cloudrift-ai/aipc/docs/system-check.md

# System check

Generated by `make check` from the part specs in [parts/](../parts/README.md), the assembly coverage in [models/assembly-bom.json](../models/assembly-bom.json) and the renders. Do not edit by hand.

Statuses: **FAIL** means declared data conflicts; **BLOCKED** means the data needed to decide is missing; **provisional** means it passes, but on weak evidence (listing, photo estimate, allowance, assumption) or a configured limit; **pass** means it passes on datasheet, standard or measured values only. A check run against the same assumed numbers does not validate them.

**Summary:** 23 BLOCKED, 56 provisional, 11 pass

## Unspecified parts

These parts have not been chosen, so nothing that depends on them can be checked:

- [mains-power](../parts/purchased/mains-power/README.md): AC supply for both PSUs
- [rack-cabinet](../parts/purchased/rack-cabinet/README.md): cabinet that receives the shelf and the roof exhaust

## Compatibility

| Status | Rule | Interface | Detail |
| --- | --- | --- | --- |
| BLOCKED | budget | `ac-power` | load 2531.0 W; capacity unknown |
| BLOCKED | value | `cabinet-front-clearance` | system needs 20.0; provider value unknown (H115i fan screws reach Y-20, in front of the front rail plane at the deck front (Y0); door must clear) |
| BLOCKED | value | `cabinet-height-above-shelf` | system needs 400.0; provider value unknown (where the roof flange was placed, not a derived need: the pressure fan top is Z233.4 and the 6 in duct bend adds to that. Replace with the real cabinet ceiling once known) |
| BLOCKED | value | `cabinet-rear-clearance` | system needs 176.3; provider value unknown (rear AIO screw heads at Y852.5 behind the rear rail plane at Y711.2 (28 in rail distance) plus 35 mm driver reserve; more at shorter rail distances) |
| BLOCKED | count | `gpu-power` | need 1 x gpu-power=12v-2x6, have None |
| BLOCKED | presence | `pcie-card-airflow` | nothing in systems ['berserk', 'kenshin'] provides 'pcie-card-airflow' |
| BLOCKED | presence | `qsfp28-dac` | nothing in systems ['berserk', 'kenshin'] provides 'qsfp28-dac' |
| BLOCKED | value | `rack-post-depth` | hammond-rsus1931bk1 needs 457.2..711.2; provider value unknown (front-to-rear rack-post spacing range accepted by the slides) |
| BLOCKED | value | `rack-standard` | hammond-rsus1931bk1 needs EIA-310 19 in; provider value unknown |
| BLOCKED | count | `rack-units` | need 11 x rack-units, have None |
| BLOCKED | count | `sata-power` | need 1 x sata-power, have None |
| BLOCKED | count | `usb2-header` | need 1 x usb2-header, have None |
| provisional | value | `aio-pump-mount` | asetek-tr4-bracket needs Asetek round pump; provided by corsair-h115i |
| provisional | count | `aio-pump-mount` | need 1 x aio-pump-mount=asetek round pump, have 1 |
| provisional | count | `atx-24pin` | need 1 x atx-24pin, have 1 |
| provisional | count | `atx-24pin` | need 1 x atx-24pin, have 1 |
| provisional | value | `board-standoff` | gigabyte-x870e-aorus-pro needs #6-32 F/F; provided by keystone-1451b (ATX pattern; B optional if the PCB has it) |
| provisional | value | `board-standoff` | huananzhi-h12d-8d needs #6-32 F/F; provided by keystone-1451b (populated sites A/C/F/G/H/K/L/M) |
| provisional | count | `board-standoff` | need 17 x board-standoff=#6-32 f/f, have 17 |
| provisional | value | `cooler-mount` | amd-epyc-7702p needs SP3; provided by asetek-tr4-bracket (the SP3 IHS is far larger than a round desktop cold plate) |
| provisional | budget | `dc-power` | load 1096.0 W of 1600.0 W x derate 0.8 = 1280.0 W (68% of rating); relies on configured limits of ['nvidia-v100-pcie-16gb']; unlimited peak 1376.0 W |
| provisional | budget | `dc-power` | load 908.0 W of 1200.0 W x derate 0.8 = 960.0 W (76% of rating) |
| provisional | budget | `dc-power` | load 23.2 W of 2800.0 W x derate 0.8 = 2240.0 W (1% of rating) |
| provisional | value | `duct-connection` | flex-duct-6in needs 6 in; provided by gpu_exhaust_fan_flange, gpu_exhaust_roof_flange |
| provisional | count | `duct-connection` | need 2 x duct-connection=6 in, have 2 |
| provisional | count | `eps-8pin-cpu` | need 2 x eps-8pin-cpu, have 2 |
| provisional | count | `eps-8pin-cpu` | need 2 x eps-8pin-cpu, have 2 |
| provisional | value | `fan-mount` | sanyo-denki-9gv1412p1s001 needs 140 mm, 124.5 mm pitch; provided by gpu_exhaust_fan_flange, v100_gpu_shroud (inlet on the hood panel, outlet on the exhaust flange) |
| provisional | count | `fan-mount` | need 2 x fan-mount=140 mm, 124.5 mm pitch, have 2 |
| provisional | value | `fan-power` | sanyo-denki-9gv1412p1s001 needs 12 V PWM 4-wire, 3.1 A; provided by fan-power-harness |
| provisional | count | `fan-power` | need 1 x fan-power=12 v pwm 4-wire, 3.1 a, have 1 |
| provisional | value | `fan-pwm-control` | fan-power-harness needs 25 kHz PWM + tach, Linux hwmon; provided by aquacomputer-quadro |
| provisional | count | `fan-pwm-control` | need 1 x fan-pwm-control=25 khz pwm + tach, linux hwmon, have 4 |
| provisional | count | `gpu-forced-airflow` | need 4 x gpu-forced-airflow, have 4 |
| provisional | value | `gpu-power` | zotac-rtx-5090-solid needs 12V-2x6; provided by corsair-hx1200i |
| provisional | value | `m2-slot` | micron-3400-2tb needs M.2 2280 NVMe; provided by huananzhi-h12d-8d |
| provisional | value | `m2-slot` | micron-3500-2tb needs M.2 2280 NVMe; provided by huananzhi-h12d-8d |
| provisional | count | `m2-slot` | need 3 x m2-slot=m.2 2280 nvme, have 3 |
| provisional | value | `m2-slot` | samsung-990-pro-4tb needs M.2 2280 NVMe; provided by gigabyte-x870e-aorus-pro |
| provisional | count | `m2-slot` | need 2 x m2-slot=m.2 2280 nvme, have 4 |
| provisional | value | `memory-slot` | corsair-cmp64gx5m4b6400c32 needs DDR5 UDIMM; provided by gigabyte-x870e-aorus-pro |
| provisional | count | `memory-slot` | need 4 x memory-slot=ddr5 udimm, have 4 |
| provisional | value | `memory-slot` | micron-mta36asf4g72pz-2g9 needs DDR4 RDIMM; provided by huananzhi-h12d-8d |
| provisional | count | `memory-slot` | need 8 x memory-slot=ddr4 rdimm, have 8 |
| provisional | value | `mobo-front-section` | gigabyte-x870e-aorus-pro needs ATX; provided by atx_mobo_adapter_front |
| provisional | value | `mobo-front-section` | huananzhi-h12d-8d needs ATX; provided by atx_mobo_adapter_front |
| provisional | count | `mobo-front-section` | need 2 x mobo-front-section=atx, have 2 |
| provisional | value | `mobo-rear-rail` | gigabyte-x870e-aorus-pro needs ATX standard slot positions; provided by atx_mobo_adapter_rail |
| provisional | count | `mobo-rear-rail` | need 1 x mobo-rear-rail=atx standard slot positions, have 1 |
| provisional | value | `mobo-rear-rail` | huananzhi-h12d-8d needs H12D-8D slot positions; provided by h12d_mobo_adapter_rail |
| provisional | count | `mobo-rear-rail` | need 1 x mobo-rear-rail=h12d-8d slot positions, have 1 |
| provisional | count | `pcie-8pin` | need 8 x pcie-8pin, have 8 |
| provisional | value | `pcie-card-envelope` | nvidia-v100-pcie-16gb needs 40.0; provided by huananzhi-h12d-8d |
| provisional | value | `pcie-x4-slot` | nvidia-mcx4131a-gcat needs PCIe x8 card, x4 link; provided by gigabyte-x870e-aorus-pro, linkreal-lrfc6911n (x8 edge connector, PCIe 3.0 8 GT/s; needs an open-ended or x16 physical slot; x4 electrical trains at x4) |
| provisional | count | `pcie-x4-slot` | need 2 x pcie-x4-slot=pcie x8 card, x4 link, have 3 |
| provisional | count | `peripheral-12v` | need 1 x peripheral-12v, have 2 |
| provisional | value | `psu-restraint` | corsair-hx1200i needs ATX 150 x 86 face; provided by psu_bracket |
| provisional | value | `psu-restraint` | rosewill-hercules-1600 needs ATX 150 x 86 face; provided by psu_bracket |
| provisional | count | `psu-restraint` | need 2 x psu-restraint=atx 150 x 86 face, have 2 |
| provisional | value | `radiator-mount` | corsair-h115i needs 280 mm, 124.5 mm pitch; provided by fan140_aio_frame |
| provisional | count | `radiator-mount` | need 2 x radiator-mount=280 mm, 124.5 mm pitch, have 2 |
| provisional | value | `radiator-mount` | lian-li-ga2-lite-360 needs 360 mm, 105 mm pitch; provided by fan120_aio_frame |
| provisional | count | `radiator-mount` | need 2 x radiator-mount=360 mm, 105 mm pitch, have 2 |
| provisional | value | `sff-8643-port` | sff-8643-pcie-cable needs PCIe x4 device; provided by linkreal-lrfc6911n (device end on the riser) |
| provisional | count | `sff-8643-port` | need 1 x sff-8643-port=pcie x4 device, have 1 |
| provisional | budget | `shelf-load` | load 23.7 kg of 39.0 kg x derate 1.0 = 39.0 kg (61% of rating) |
| provisional | value | `v100-aux-power` | nvidia-v100-pcie-16gb needs CPU/EPS 8-pin; provided by v100-eps-power-adapter |
| provisional | count | `v100-aux-power` | need 4 x v100-aux-power=cpu/eps 8-pin, have 4 |
| pass | value | `cooler-mount` | amd-ryzen-9-9950x3d needs AM5; provided by lian-li-ga2-lite-360 |
| pass | value | `cpu-socket` | amd-epyc-7702p needs SP3; provided by huananzhi-h12d-8d |
| pass | value | `cpu-socket` | amd-ryzen-9-9950x3d needs AM5; provided by gigabyte-x870e-aorus-pro |
| pass | value | `pcie-x16-slot` | nvidia-v100-pcie-16gb needs PCIe x16; provided by huananzhi-h12d-8d (PCIe 3.0 card in a PCIe 4.0 slot) |
| pass | count | `pcie-x16-slot` | need 4 x pcie-x16-slot=pcie x16, have 4 |
| pass | value | `pcie-x16-slot` | zotac-rtx-5090-solid needs PCIe x16; provided by gigabyte-x870e-aorus-pro |
| pass | count | `pcie-x16-slot` | need 1 x pcie-x16-slot=pcie x16, have 1 |
| pass | value | `post-base-thread` | obt-pcie-support needs M3 female; provided by wurth-970140324 |
| pass | count | `post-base-thread` | need 10 x post-base-thread=m3 female, have 10 |
| pass | value | `sff-8643-port` | sff-8643-pcie-cable needs PCIe 4.0 x4 U.2; provided by huananzhi-h12d-8d (host end on an H12D-8D SFF-8643 port set to PCIe mode) |
| pass | count | `sff-8643-port` | need 1 x sff-8643-port=pcie 4.0 x4 u.2, have 3 |

## Assembly coverage

Every assembly instance belongs to a part folder or a declared keepout. Parts not in the assembly, and unresolved geometry conflicts the layout reports:

- **aquacomputer-quadro**: not in the assembly: outline not published and mounting place not chosen; small enough for the hood side or the H12D front edge
- **corsair-cmp64gx5m4b6400c32**: not in the assembly: X870E DIMM socket positions not surveyed; model them before trusting pump and hose clearance
- **linkreal-lrfc6911n**: not in the assembly: shelf location and holder not designed yet; must clear the V100s and the BMC and leave airflow over the NIC
- **mains-power**: not in the assembly: outside the shelf; supply not specified
- **nvidia-mcx4131a-gcat**: not in the assembly: card positions not chosen: Berserk's sits on a riser whose shelf location is open, and Kenshin's PCIEX4 slot clearance under the RTX 5090 is unchecked
- **samsung-990-pro-4tb**: not in the assembly: X870E M.2 slot positions not surveyed; drives sit under the board heatsinks
- **sff-8643-pcie-cable**: not in the assembly: cable route follows the riser location, which is not chosen yet
- **tnut_fit_coupon**: not in the assembly: fit coupon, not installed
- **fan-power-harness**: not in the assembly: flexible wiring; route along the hood clear of the fan rotor
- **Berserk V100 16GB PCIE2 / Berserk BMC module survey**: geometry conflict in the layout: unresolved conservative envelopes: BMC height and GPU underside are unmeasured; inspect actual clearance before assembly
- **Berserk V100 16GB PCIE3 / Berserk BMC module survey**: geometry conflict in the layout: unresolved conservative envelopes: BMC height and GPU underside are unmeasured; inspect actual clearance before assembly

## Datasheets

- **ac-power-cords**: no datasheet recorded. Not selected. HX1200i wants a low-profile or down-exit C13; match the Hercules inlet and the UPS outlet (possibly C19).
- **asetek-tr4-bracket**: no datasheet recorded. Not yet sourced. Record the product and confirm it lists the original H115i pump before buying.
- **corsair-cmp64gx5m4b6400c32**: no datasheet recorded. Add Corsair's product page for this kit.
- **corsair-h115i**: no datasheet recorded. Reused unit; exact revision not recorded. Add the Corsair spec sheet for that revision.
- **corsair-hx1200i**: no datasheet recorded. Revision not recorded: the 2017 HX1200i (CP-9020070, 200 mm) has no 12V-2x6 cable; the 2023 ATX 3.x unit (CP-9020281) has one. Record the label and add its spec sheet.
- **fasteners**: no datasheet recorded. Generic ISO metric hardware; choose lengths from measured stacks (see docs/assembly.md).
- **flex-duct-6in**: no datasheet recorded. Not selected; any 152 mm ID wire-supported duct.
- **keystone-1451b**: no datasheet recorded. Only the DigiKey listing is recorded; add Keystone's drawing.
- **moddiy-eps-90-extension**: no datasheet recorded. MODDIY product page not recorded; the 18 mm projection is a design target, not a product dimension.
- **obt-pcie-support**: no datasheet recorded. Open Benchtable publishes no drawing; the stud length is an owner measurement.
- **rosewill-hercules-1600**: no datasheet recorded. Owned unit; record its model number and add Rosewill's spec sheet. Connector counts below are assumptions.
- **sff-8643-pcie-cable**: no datasheet recorded. Marketplace cable; 10Gtek publishes no drawing or PCIe rating for it. Listings give 12G SAS, 100 ohm, 30 AWG, sideband.
- **silicone-gasket-2mm**: no datasheet recorded. Generic sheet.
- **v100-eps-power-adapter**: no datasheet recorded. Generic marketplace adapter; check its pinout against the NVIDIA brief before use.
- **v100-tail-support**: no datasheet recorded. Generic hardware; choose after measuring the card frame height.

Not fetched locally (run `make datasheets`): amd-epyc-7702p, amd-ryzen-9-9950x3d, gigabyte-x870e-aorus-pro, micron-3500-2tb, wurth-970140324, zotac-rtx-5090-solid.

## Weak-evidence dimensions

Dimensions not backed by a datasheet, standard or measurement, by part:

- amd-epyc-7702p: 1 assumed, 1 datasheet
- amd-ryzen-9-9950x3d: 1 assumed, 1 datasheet, 1 standard
- aquacomputer-quadro: 1 assumed, 1 datasheet
- asetek-tr4-bracket: 1 assumed
- atx_mobo_adapter_front: 1 allowance
- atx_mobo_adapter_rail: 1 allowance
- corsair-cmp64gx5m4b6400c32: 1 assumed
- corsair-h115i: 4 assumed, 3 standard
- corsair-hx1200i: 2 assumed, 2 standard
- fan-power-harness: 1 allowance, 1 assumed
- fan120_aio_center_spacer: 1 allowance
- fan120_aio_frame: 1 allowance
- fan120_aio_hose_brace: 1 allowance
- fan140_aio_frame: 1 allowance
- fan140_aio_hose_brace: 1 allowance
- fasteners: 1 assumed
- gigabyte-x870e-aorus-pro: 1 assumed, 2 datasheet
- gpu_exhaust_fan_flange: 1 allowance
- gpu_exhaust_roof_flange: 1 allowance
- gpu_rest: 1 allowance
- h12d_mobo_adapter_rail: 1 allowance
- hammond-rsus1931bk1: 1 allowance, 10 datasheet, 3 photo-estimate, 1 unknown
- huananzhi-h12d-8d: 2 assumed, 2 datasheet
- keystone-1451b: 1 assumed, 1 listing
- lian-li-ga2-lite-360: 1 allowance, 1 assumed, 6 datasheet, 1 standard
- micron-3400-2tb: 2 assumed, 5 datasheet
- micron-3500-2tb: 2 assumed, 2 standard
- micron-mta36asf4g72pz-2g9: 2 assumed
- moddiy-eps-90-extension: 1 allowance, 1 assumed
- nvidia-mcx4131a-gcat: 1 assumed, 5 datasheet
- nvidia-v100-pcie-16gb: 1 allowance, 4 datasheet
- obt-pcie-support: 1 allowance, 1 assumed, 1 measured
- psu_bracket: 1 allowance
- rack-cabinet: 3 unknown
- rear-aio-steel-extension: 4 allowance
- rosewill-hercules-1600: 1 allowance, 1 assumed, 2 standard
- samsung-990-pro-4tb: 1 assumed
- sff-8643-pcie-cable: 1 assumed, 1 listing
- tnut_fit_coupon: 1 allowance
- v100-eps-power-adapter: 1 assumed
- v100-tail-support: 2 allowance, 1 assumed
- v100_gpu_shroud: 1 allowance
- wurth-970140324: 1 assumed, 3 datasheet
- zotac-rtx-5090-solid: 1 assumed, 4 datasheet
