cloudrift-ai/aipc/models/aio-fan-aligned-mounts.png

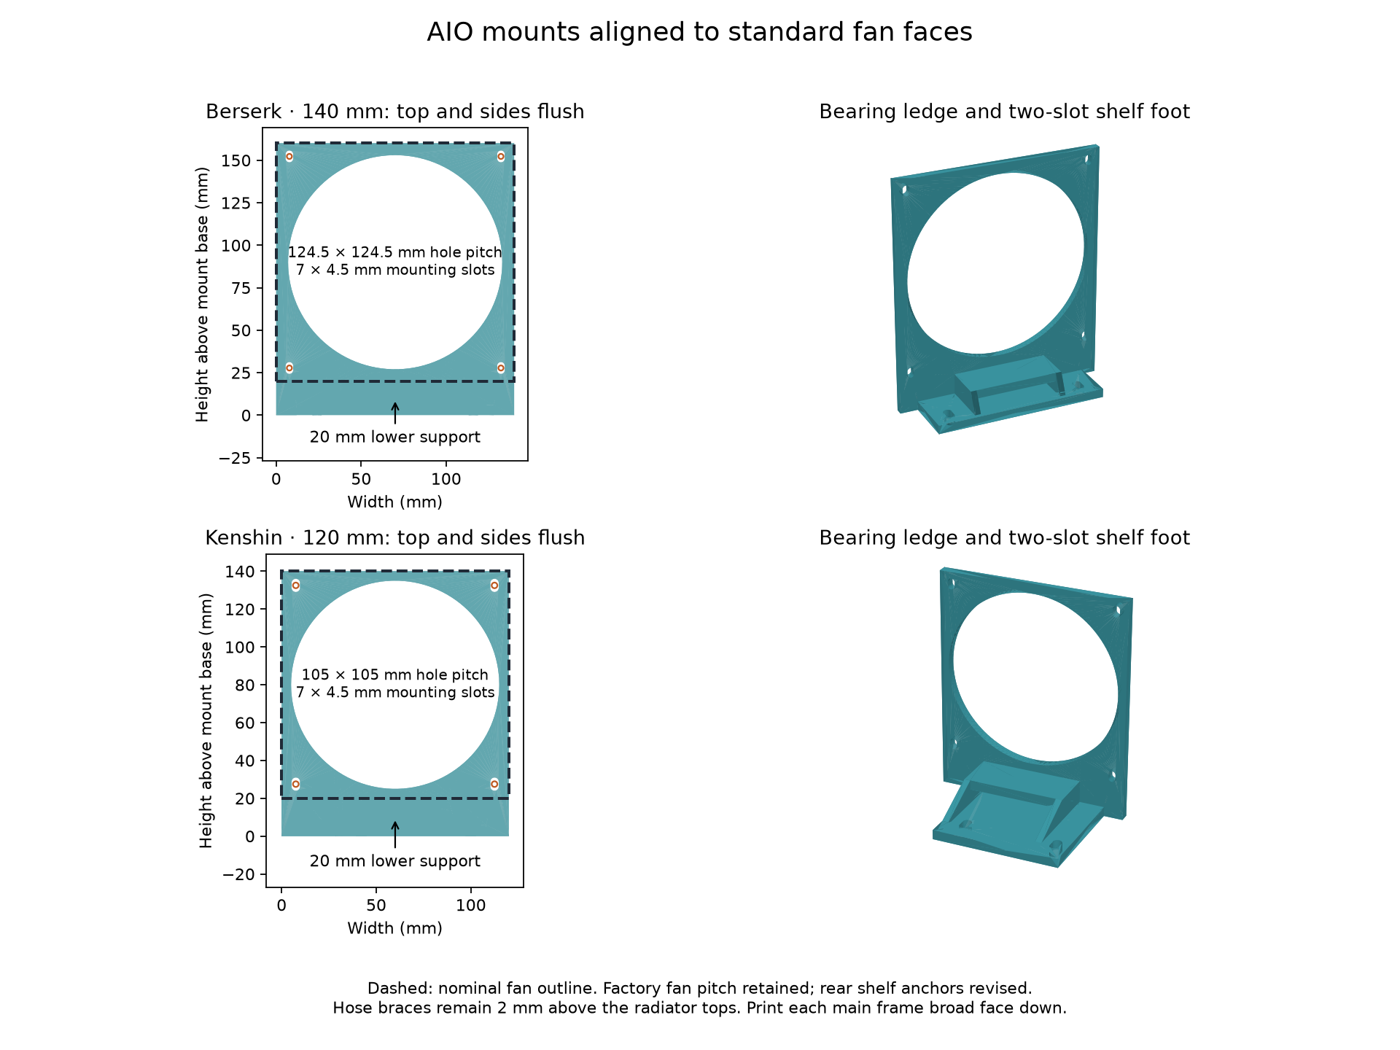
models/aio-fan-aligned-mounts.png
