cloudrift-ai/aipc/models/gpu-exhaust-preview.png

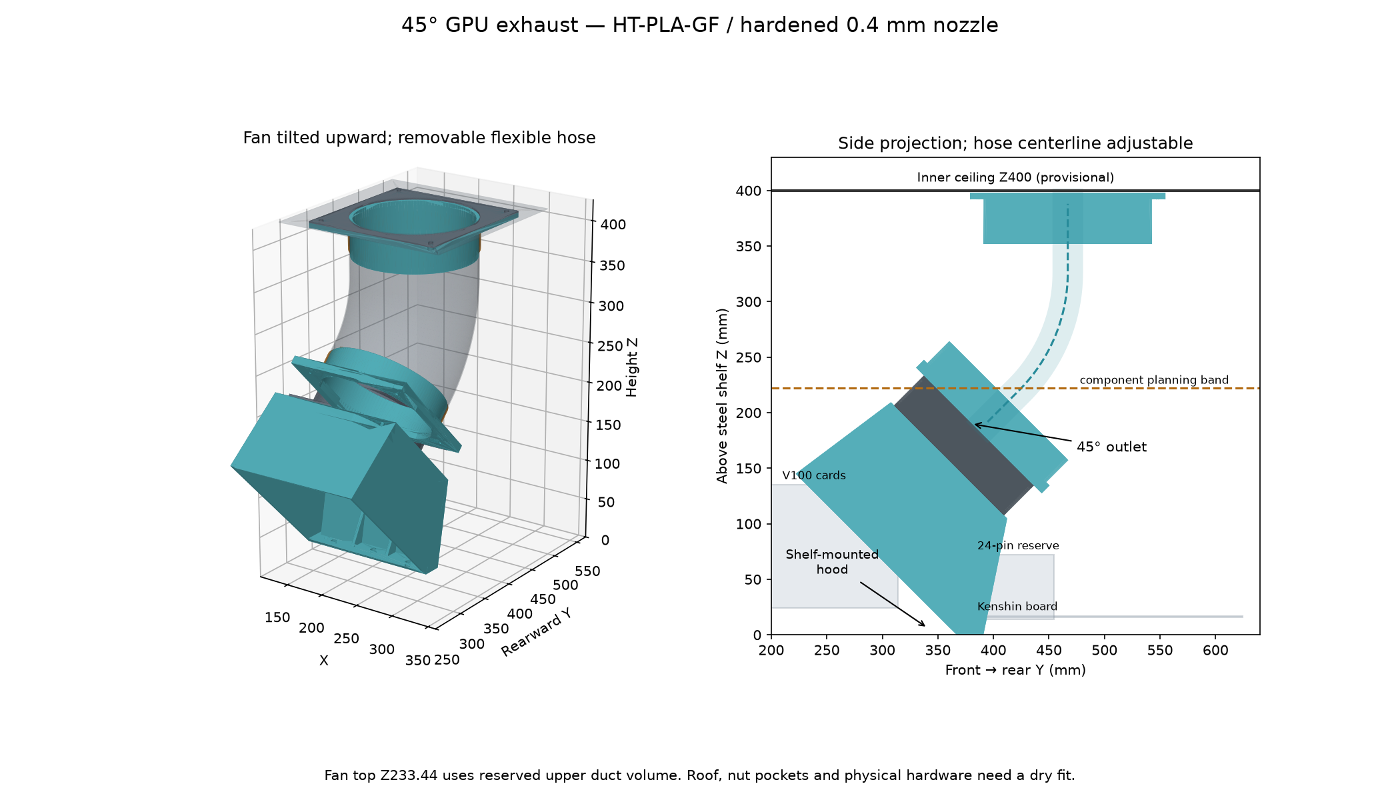
models/gpu-exhaust-preview.png
