cloudrift-ai/aipc/models/kenshin-aio-brace-and-frames.png

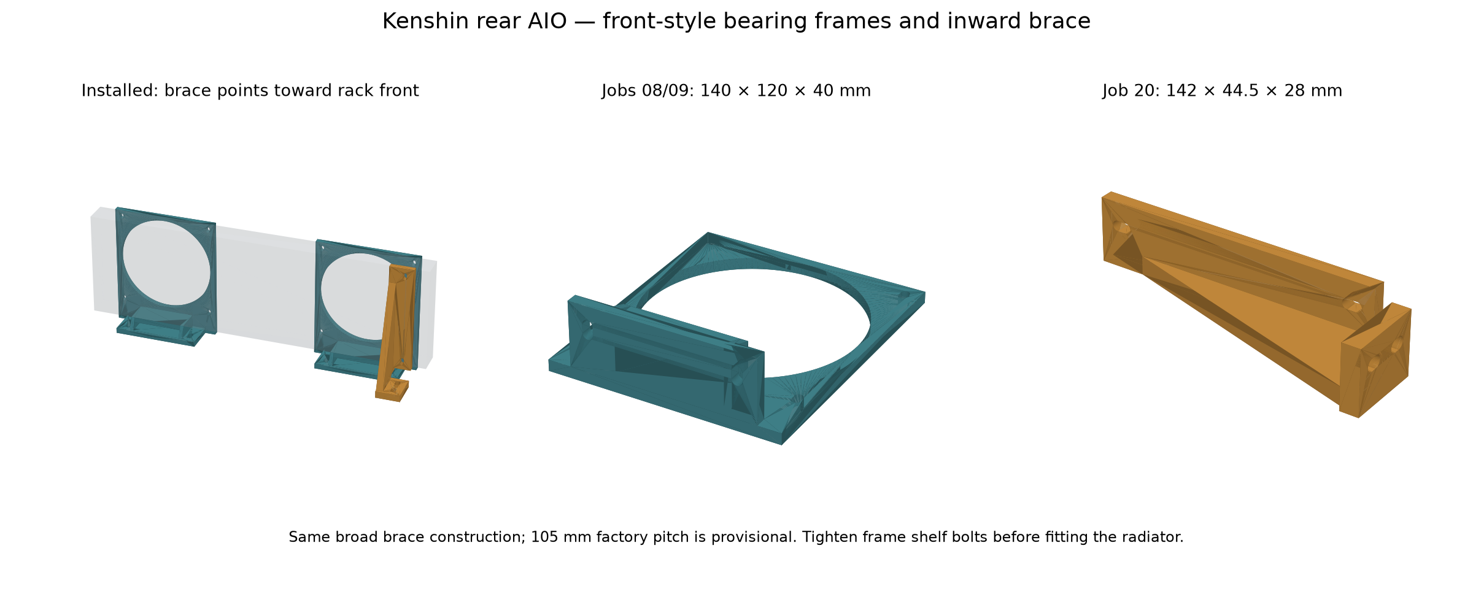
models/kenshin-aio-brace-and-frames.png
