cloudrift-ai/aipc/models/v100-cooling.png

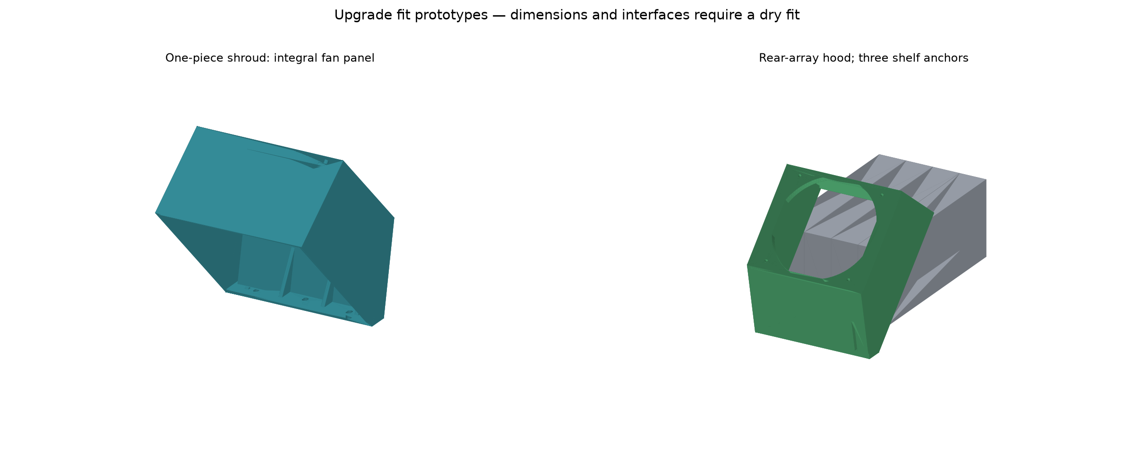
models/v100-cooling.png
