cloudrift-ai/aipc/parts/README.md

# Parts

<!-- Generated by make check. Edit each part.toml, not this file. -->

One folder per part: `part.toml` (spec, evidence, interfaces), a generated `README.md`, the model used in the assembly (`<id>.step`), `render.png` and `in-assembly.png`, and fetched `datasheets/`. See [docs/process.md](../docs/process.md) for the workflow and [docs/system-check.md](../docs/system-check.md) for the latest compatibility results.

## Purchased

| Part | Qty | Status | Systems | Worst check | Role |
| --- | ---: | --- | --- | --- | --- |
| [ac-power-cords](purchased/ac-power-cords/README.md) | 2 | candidate | berserk, kenshin | - | PSU mains cords |
| [amd-epyc-7702p](purchased/amd-epyc-7702p/README.md) | 1 | owned | berserk | provisional | Berserk CPU |
| [amd-ryzen-9-9950x3d](purchased/amd-ryzen-9-9950x3d/README.md) | 1 | owned | kenshin | pass | Kenshin CPU |
| [aquacomputer-quadro](purchased/aquacomputer-quadro/README.md) | 1 | selected | berserk | BLOCKED | PWM and tach for the V100 pressure fan, driven from GPU temperature by the host |
| [asetek-tr4-bracket](purchased/asetek-tr4-bracket/README.md) | 1 | selected | berserk | provisional | mounts the H115i pump on the EPYC SP3 socket |
| [corsair-cmp64gx5m4b6400c32](purchased/corsair-cmp64gx5m4b6400c32/README.md) | 1 | owned | kenshin | provisional | Kenshin memory |
| [corsair-h115i](purchased/corsair-h115i/README.md) | 1 | owned | berserk | provisional | Berserk CPU cooler, front of shelf |
| [corsair-hx1200i](purchased/corsair-hx1200i/README.md) | 1 | owned | kenshin | BLOCKED | Kenshin PSU |
| [fasteners](purchased/fasteners/README.md) | 1 | candidate | berserk, kenshin, shelf | - | 45 shelf joints plus radiator, fan, flange and roof screws |
| [flex-duct-6in](purchased/flex-duct-6in/README.md) | 1 | candidate | berserk | provisional | GPU exhaust to cabinet ceiling |
| [gigabyte-x870e-aorus-pro](purchased/gigabyte-x870e-aorus-pro/README.md) | 1 | owned | kenshin | provisional | Kenshin motherboard |
| [hammond-rsus1931bk1](purchased/hammond-rsus1931bk1/README.md) | 1 | selected | shelf, rack | BLOCKED | sliding shelf carrying both PCs |
| [huananzhi-h12d-8d](purchased/huananzhi-h12d-8d/README.md) | 1 | owned | berserk | BLOCKED | Berserk motherboard |
| [keystone-1451b](purchased/keystone-1451b/README.md) | 17 | selected | berserk, kenshin | provisional | motherboard standoffs |
| [lian-li-ga2-lite-360](purchased/lian-li-ga2-lite-360/README.md) | 1 | owned | kenshin | provisional | Kenshin CPU cooler, rear of shelf |
| [linkreal-lrfc6911n](purchased/linkreal-lrfc6911n/README.md) | 1 | selected | berserk | BLOCKED | Berserk NIC slot: takes an H12D-8D SFF-8643 PCIe x4 port and provides an x16 slot for the ConnectX |
| [mains-power](purchased/mains-power/README.md) | 1 | unspecified | rack | BLOCKED | AC supply for both PSUs |
| [mcmaster-53185k52](purchased/mcmaster-53185k52/README.md) | 2 | selected | berserk | - | duct clamps |
| [micron-3400-2tb](purchased/micron-3400-2tb/README.md) | 2 | owned | berserk | provisional | Berserk model storage, two of the three RAID 0 members |
| [micron-3500-2tb](purchased/micron-3500-2tb/README.md) | 1 | owned | berserk | provisional | Berserk model storage, one of the three RAID 0 members |
| [micron-mta36asf4g72pz-2g9](purchased/micron-mta36asf4g72pz-2g9/README.md) | 8 | owned | berserk | provisional | Berserk memory, 8 x 32 GB |
| [moddiy-eps-90-extension](purchased/moddiy-eps-90-extension/README.md) | 4 | selected | berserk | - | keeps V100 power plugs low and clear of the front radiator |
| [nvidia-mcx4131a-gcat](purchased/nvidia-mcx4131a-gcat/README.md) | 2 | owned | berserk, kenshin | BLOCKED | Direct Berserk-Kenshin link over a QSFP28 DAC (one card per system) |
| [nvidia-v100-pcie-16gb](purchased/nvidia-v100-pcie-16gb/README.md) | 4 | selected | berserk | provisional | Berserk GPUs (passive, ducted) |
| [obt-pcie-support](purchased/obt-pcie-support/README.md) | 10 | selected | berserk, kenshin | pass | GPU bracket posts (two per card) |
| [rack-cabinet](purchased/rack-cabinet/README.md) | 1 | unspecified | rack | BLOCKED | cabinet that receives the shelf and the roof exhaust |
| [rosewill-hercules-1600](purchased/rosewill-hercules-1600/README.md) | 1 | owned | berserk | BLOCKED | Berserk PSU |
| [samsung-990-pro-4tb](purchased/samsung-990-pro-4tb/README.md) | 2 | owned | kenshin | provisional | Kenshin storage |
| [sanyo-denki-9gv1412p1s001](purchased/sanyo-denki-9gv1412p1s001/README.md) | 1 | selected | berserk | provisional | pressure fan pulling air through the four V100s |
| [sff-8643-pcie-cable](purchased/sff-8643-pcie-cable/README.md) | 1 | selected | berserk | provisional | PCIe x4 link from an H12D-8D SFF-8643 port to the Linkreal LRFC6911N riser |
| [silicone-gasket-2mm](purchased/silicone-gasket-2mm/README.md) | 1 | candidate | berserk | - | roof flange seal |
| [v100-eps-power-adapter](purchased/v100-eps-power-adapter/README.md) | 4 | selected | berserk | provisional | V100 auxiliary power adapter |
| [v100-tail-support](purchased/v100-tail-support/README.md) | 4 | candidate | berserk | - | V100 tail support |
| [wurth-970140324](purchased/wurth-970140324/README.md) | 10 | selected | berserk, kenshin | pass | GPU post bases, bearing directly on the steel shelf |
| [zotac-rtx-5090-solid](purchased/zotac-rtx-5090-solid/README.md) | 1 | owned | kenshin | BLOCKED | Kenshin GPU |

## Printed

| Part | Qty | Status | Systems | Worst check | Role |
| --- | ---: | --- | --- | --- | --- |
| [atx_mobo_adapter_front](printed/atx_mobo_adapter_front/README.md) | 2 | design | berserk, kenshin | provisional | shelf-front motherboard section, common to both boards |
| [atx_mobo_adapter_rail](printed/atx_mobo_adapter_rail/README.md) | 1 | design | kenshin | provisional | Kenshin rear rail with GPU post holes at standard ATX positions |
| [fan120_aio_center_spacer](printed/fan120_aio_center_spacer/README.md) | 1 | design | kenshin | - | keeps the middle 120 mm fan coplanar |
| [fan120_aio_frame](printed/fan120_aio_frame/README.md) | 2 | design | kenshin | provisional | 120 mm fan/radiator frame with 75 mm feet on the steel extension |
| [fan120_aio_hose_brace](printed/fan120_aio_hose_brace/README.md) | 1 | design | kenshin | - | mirrored left hose-end brace for the 120 mm radiator |
| [fan140_aio_frame](printed/fan140_aio_frame/README.md) | 2 | design | berserk | provisional | 140 mm fan/radiator frame with bearing ledge (H115i) |
| [fan140_aio_hose_brace](printed/fan140_aio_hose_brace/README.md) | 1 | design | berserk | - | hose-end brace for the 140 mm radiator |
| [gpu_exhaust_fan_flange](printed/gpu_exhaust_fan_flange/README.md) | 1 | design | berserk | provisional | fan outlet to 6 in duct |
| [gpu_exhaust_roof_flange](printed/gpu_exhaust_roof_flange/README.md) | 1 | design | berserk | provisional | duct to cabinet inner ceiling |
| [gpu_rest](printed/gpu_rest/README.md) | 1 | design | kenshin | - | front-end rest for the RTX 5090 |
| [h12d_mobo_adapter_rail](printed/h12d_mobo_adapter_rail/README.md) | 1 | design | berserk | provisional | Berserk rear rail with GPU post holes for four dual-slot V100s |
| [psu_bracket](printed/psu_bracket/README.md) | 2 | design | berserk, kenshin | provisional | rear restraint for an 86 x 150 mm ATX PSU face |
| [tnut_fit_coupon](printed/tnut_fit_coupon/README.md) | 1 | design | berserk | - | test print for the M4 hammer T-nut pocket |
| [v100_gpu_shroud](printed/v100_gpu_shroud/README.md) | 1 | design | berserk | provisional | hood over the four V100s with integral 45 degree fan panel |

## Fabricated

| Part | Qty | Status | Systems | Worst check | Role |
| --- | ---: | --- | --- | --- | --- |
| [fan-power-harness](fabricated/fan-power-harness/README.md) | 1 | design | berserk | provisional | feeds the San Ace motor from the PSU and passes PWM/tach to the QUADRO |
| [rear-aio-steel-extension](fabricated/rear-aio-steel-extension/README.md) | 1 | design | kenshin, shelf | - | carries the rear radiator feet beyond the deck |
