cloudrift-ai/aipc/parts/purchased/amd-ryzen-9-9950x3d/README.md

# AMD Ryzen 9 9950X3D

<!-- Generated by make check from part.toml. Edit part.toml, not this file. -->

| | |
| --- | --- |
| ID | `amd-ryzen-9-9950x3d` |
| Category | purchased |
| Role | Kenshin CPU |
| Status | owned |
| Quantity | 1 |
| Systems | kenshin |

## Model

- Source: constructed
- Assembly: inside the envelope of `lian-li-ga2-lite-360`

## Datasheets

- [AMD Ryzen 9 9950X3D specifications](https://www.amd.com/en/products/processors/desktops/ryzen/9000-series/amd-ryzen-9-9950x3d.html)
- Local copies: `datasheets/` after `make datasheets` (not committed)

## Dimensions

| Key | Value | Evidence | Source / note |
| --- | --- | --- | --- |
| tdp | 170 W | datasheet | AMD specifications |
| ppt | 230 W | standard | AM5 170 W TDP class package power |
| mass | 0.05 kg | assumed |  |

## Interfaces

- requires `cpu-socket` value AM5 (datasheet)
- requires `cooler-mount` value AM5 (datasheet)
- requires `dc-power` load 230 (standard)

## Compatibility checks

| Status | Rule | Interface | Detail |
| --- | --- | --- | --- |
| provisional | budget | `dc-power` | load 908.0 W of 1200.0 W x derate 0.8 = 960.0 W (76% of rating) |
| provisional | budget | `shelf-load` | load 23.7 kg of 39.0 kg x derate 1.0 = 39.0 kg (61% of rating) |
| pass | value | `cooler-mount` | amd-ryzen-9-9950x3d needs AM5; provided by lian-li-ga2-lite-360 |
| pass | value | `cpu-socket` | amd-ryzen-9-9950x3d needs AM5; provided by gigabyte-x870e-aorus-pro |
