cloudrift-ai/aipc/parts/purchased/aquacomputer-quadro/README.md

# Aquacomputer QUADRO fan controller (53256)

<!-- Generated by make check from part.toml. Edit part.toml, not this file. -->

| | |
| --- | --- |
| ID | `aquacomputer-quadro` |
| Category | purchased |
| Role | PWM and tach for the V100 pressure fan, driven from GPU temperature by the host |
| Status | selected |
| Quantity | 1 |
| Systems | berserk |
| Product | <https://shop.aquacomputer.de/Monitoring-and-Controlling/QUADRO-and-OCTO/QUADRO-fan-controller-for-PWM-fans::3773.html> |
| Linux_driver | <https://docs.kernel.org/hwmon/aquacomputer_d5next.html> |

Chosen 2026-11-06. Each output is rated 25 W, below the San Ace's 37.2 W, so
the QUADRO does not power the fan: the fused harness feeds the motor from the
PSU and only PWM, tach and ground go to a QUADRO channel. On Linux the
aquacomputer_d5next hwmon driver exposes writable pwm1-4 and fan tach; a host
service reads the hottest GPU (nvidia-smi) and writes the duty. If the PWM
line goes open the San Ace runs at 100% (catalog p.185 note), but a running
QUADRO holds its last duty if the host service dies: the service must set
100% on start, on exit and on any error, and stop GPU load if tach is lost.
Initial configuration software (aquasuite) is Windows-only; Linux control
needs no configuration. Whether its outputs float when unpowered is not
documented.

## Model

- Source: constructed
- Assembly: **not in the assembly**: outline not published and mounting place not chosen; small enough for the hood side or the H12D front edge

## Datasheets

- [QUADRO product page](https://shop.aquacomputer.de/Monitoring-and-Controlling/QUADRO-and-OCTO/QUADRO-fan-controller-for-PWM-fans::3773.html)
- [Linux aquacomputer_d5next hwmon driver](https://docs.kernel.org/hwmon/aquacomputer_d5next.html)
- Local copies: `datasheets/` after `make datasheets` (not committed)

## Dimensions

| Key | Value | Evidence | Source / note |
| --- | --- | --- | --- |
| channel_power | 25 W | datasheet | product page: max 25 W per channel |
| mass | 0.1 kg | assumed |  |

## Interfaces

- provides `fan-pwm-control` value 25 kHz PWM + tach, Linux hwmon count 4 (datasheet) — product page: four 4-pin PWM outputs with speed monitoring; kernel driver pwm writable
- requires `usb2-header` count 1 (datasheet) — internal USB 2.0 header; cable about 100 cm included
- requires `dc-power` load 2 (assumed)

## Compatibility checks

| Status | Rule | Interface | Detail |
| --- | --- | --- | --- |
| BLOCKED | count | `usb2-header` | need 1 x usb2-header, have None |
| provisional | budget | `dc-power` | load 1096.0 W of 1600.0 W x derate 0.8 = 1280.0 W (68% of rating); relies on configured limits of ['nvidia-v100-pcie-16gb']; unlimited peak 1376.0 W |
| provisional | value | `fan-pwm-control` | fan-power-harness needs 25 kHz PWM + tach, Linux hwmon; provided by aquacomputer-quadro |
| provisional | count | `fan-pwm-control` | need 1 x fan-pwm-control=25 khz pwm + tach, linux hwmon, have 4 |
| provisional | budget | `shelf-load` | load 23.7 kg of 39.0 kg x derate 1.0 = 39.0 kg (61% of rating) |
