cloudrift-ai/aipc/parts/purchased/asetek-tr4-bracket/README.md

# Asetek TR4/SP3 mounting bracket for round-pump AIOs

<!-- Generated by make check from part.toml. Edit part.toml, not this file. -->

| | |
| --- | --- |
| ID | `asetek-tr4-bracket` |
| Category | purchased |
| Role | mounts the H115i pump on the EPYC SP3 socket |
| Status | selected |
| Quantity | 1 |
| Systems | berserk |

Accepted by the owner on 2026-11-06 with partial cold-plate coverage. SP3 and
TR4 share the same four-post cooler mounting, so a TR4 bracket fits the
H12D-8D. The round H115i cold plate does not cover the whole 58 x 75 mm SP3
heat spreader, and the 7702P's outer dies sit near its edges: expect higher
temperatures and less headroom than a full-coverage TR4/SP3 cooler. Watch
CPU temperatures under all-core load and revisit if it throttles.

## Model

- Source: constructed
- Assembly: inside the envelope of `amd-epyc-7702p`

## Datasheets

- None recorded. Not yet sourced. Record the product and confirm it lists the original H115i pump before buying.

## Dimensions

| Key | Value | Evidence | Source / note |
| --- | --- | --- | --- |
| mass | 0.05 kg | assumed |  |

## Interfaces

- provides `cooler-mount` value SP3 (assumed) — TR4/sTRX4/SP3 share the four-post mounting; cold-plate coverage is partial
- requires `aio-pump-mount` value Asetek round pump count 1 (assumed)

## Compatibility checks

| Status | Rule | Interface | Detail |
| --- | --- | --- | --- |
| provisional | value | `aio-pump-mount` | asetek-tr4-bracket needs Asetek round pump; provided by corsair-h115i |
| provisional | count | `aio-pump-mount` | need 1 x aio-pump-mount=asetek round pump, have 1 |
| provisional | value | `cooler-mount` | amd-epyc-7702p needs SP3; provided by asetek-tr4-bracket |
| provisional | budget | `shelf-load` | load 23.7 kg of 39.0 kg x derate 1.0 = 39.0 kg (61% of rating) |
