cloudrift-ai/aipc/parts/purchased/corsair-cmp64gx5m4b6400c32/README.md

# Corsair CMP64GX5M4B6400C32 DDR5 kit, 4 x 16 GB

<!-- Generated by make check from part.toml. Edit part.toml, not this file. -->

| | |
| --- | --- |
| ID | `corsair-cmp64gx5m4b6400c32` |
| Category | purchased |
| Role | Kenshin memory |
| Status | owned |
| Quantity | 1 |
| Systems | kenshin |

## Model

- Source: constructed
- Assembly: **not in the assembly**: X870E DIMM socket positions not surveyed; model them before trusting pump and hose clearance

## Datasheets

- None recorded. Add Corsair's product page for this kit.

## Dimensions

| Key | Value | Evidence | Source / note |
| --- | --- | --- | --- |
| mass | 0.2 kg | assumed |  |

## Interfaces

- requires `memory-slot` value DDR5 UDIMM count 4 (listing)
- requires `dc-power` load 20 (assumed)

## Compatibility checks

| Status | Rule | Interface | Detail |
| --- | --- | --- | --- |
| provisional | budget | `dc-power` | load 908.0 W of 1200.0 W x derate 0.8 = 960.0 W (76% of rating) |
| provisional | value | `memory-slot` | corsair-cmp64gx5m4b6400c32 needs DDR5 UDIMM; provided by gigabyte-x870e-aorus-pro |
| provisional | count | `memory-slot` | need 4 x memory-slot=ddr5 udimm, have 4 |
| provisional | budget | `shelf-load` | load 23.7 kg of 39.0 kg x derate 1.0 = 39.0 kg (61% of rating) |
