cloudrift-ai/aipc/parts/purchased/corsair-h115i/README.md

# Corsair Hydro H115i 280 mm AIO (reused)

<!-- Generated by make check from part.toml. Edit part.toml, not this file. -->

| | |
| --- | --- |
| ID | `corsair-h115i` |
| Category | purchased |
| Role | Berserk CPU cooler, front of shelf |
| Status | owned |
| Quantity | 1 |
| Systems | berserk |

The retail H115i mounting kit covers Intel and desktop AMD sockets only. On
the EPYC it mounts with a separate TR4/SP3 bracket (asetek-tr4-bracket). The
round cold plate covers only part of the SP3 heat spreader; the owner accepted
that on 2026-11-06.

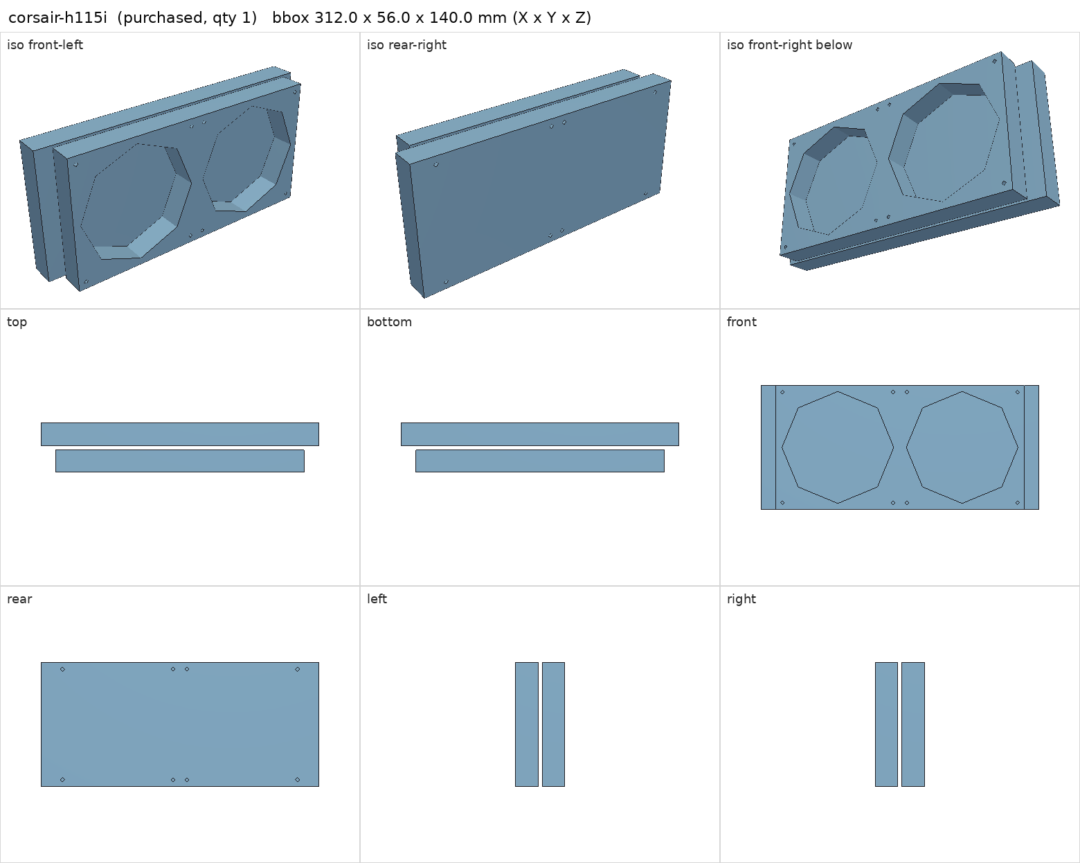
[picture p15: parts/purchased/corsair-h115i/render.png]
Part views


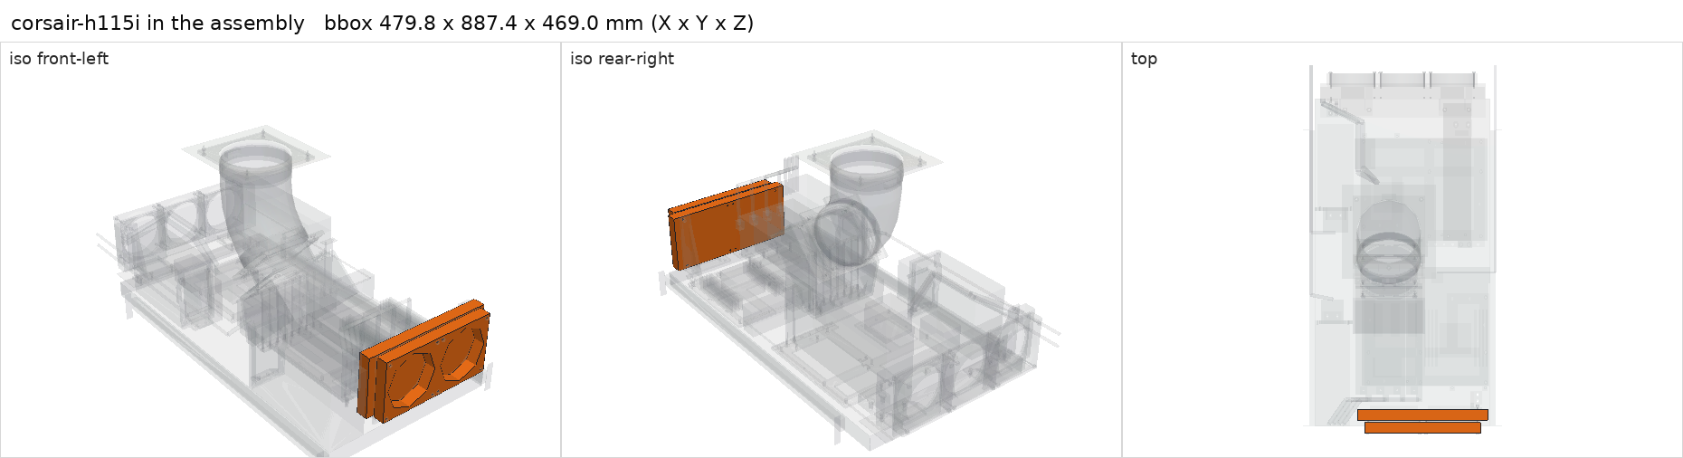
[picture p16: parts/purchased/corsair-h115i/in-assembly.png]
Part in the assembly


## Model

- [corsair-h115i.step](corsair-h115i.step)
- Source: constructed. Radiator and fan envelopes; owner measured the front bracket overhang only.
- Assembly: 2 instances in the assembly

## Datasheets

- None recorded. Reused unit; exact revision not recorded. Add the Corsair spec sheet for that revision.

## Dimensions

| Key | Value | Evidence | Source / note |
| --- | --- | --- | --- |
| radiator_length | 312 mm | assumed |  |
| radiator_thickness | 26 mm | assumed |  |
| radiator_height | 140 mm | assumed |  |
| fan_size | 140 mm | standard | 140 mm PC fan standard |
| fan_depth | 25 mm | standard | 140 x 25 mm fan |
| hole_pitch | 124.5 mm | standard | 140 mm fan hole pattern |
| mass | 1.3 kg | assumed |  |

## Interfaces

- provides `cooler-mount` accepts ['LGA115x', 'LGA1366', 'LGA2011', 'AM2', 'AM3', 'FM2'] (assumed) — retail kit only; SP3 comes from asetek-tr4-bracket
- provides `aio-pump-mount` value Asetek round pump count 1 (assumed) — confirm the bracket lists this pump revision
- requires `radiator-mount` value 280 mm, 124.5 mm pitch count 2 (assumed)
- requires `dc-power` load 12 (assumed)

## Compatibility checks

| Status | Rule | Interface | Detail |
| --- | --- | --- | --- |
| provisional | value | `aio-pump-mount` | asetek-tr4-bracket needs Asetek round pump; provided by corsair-h115i |
| provisional | count | `aio-pump-mount` | need 1 x aio-pump-mount=asetek round pump, have 1 |
| provisional | value | `cooler-mount` | amd-epyc-7702p needs SP3; provided by asetek-tr4-bracket |
| provisional | budget | `dc-power` | load 1096.0 W of 1600.0 W x derate 0.8 = 1280.0 W (68% of rating); relies on configured limits of ['nvidia-v100-pcie-16gb']; unlimited peak 1376.0 W |
| provisional | value | `radiator-mount` | corsair-h115i needs 280 mm, 124.5 mm pitch; provided by fan140_aio_frame |
| provisional | count | `radiator-mount` | need 2 x radiator-mount=280 mm, 124.5 mm pitch, have 2 |
| provisional | budget | `shelf-load` | load 23.7 kg of 39.0 kg x derate 1.0 = 39.0 kg (61% of rating) |
