cloudrift-ai/aipc/parts/purchased/huananzhi-h12d-8d/README.md

# HUANANZHI H12D-8D motherboard with BMC

<!-- Generated by make check from part.toml. Edit part.toml, not this file. -->

| | |
| --- | --- |
| ID | `huananzhi-h12d-8d` |
| Category | purchased |
| Role | Berserk motherboard |
| Status | owned |
| Quantity | 1 |
| Systems | berserk |
| Product | <https://www.huananzhi.com/en/list_6/177.html> |
| Listing | <https://www.ebay.com/itm/396800856844> |

Placement of the CPU, DIMMs, M.2 standoffs, BMC and slot planes comes from the
manufacturer photograph (cad/berserk_platform.py), not manufacturer CAD.
Standoff sites A/C/F/G/H/K/L/M are populated; B and J are absent.
First boot 2026-11-07, read from the running system: PCB V2.0 (DMI), AMI
BIOS 2.2 dated 2026-01-06, ASPEED BMC firmware 1.01 (BMC MAC
00:e0:97:2a:aa:fc, DHCP), two Intel I226-V 2.5GbE ports. The I226-V has no
BMC sideband, so the BMC needs its own RJ45 cable. The bundled EPYC 7702P
boots, so it is not locked to another vendor's board. The BMC reports FAN1-8
headers and inlet/outlet temperatures.

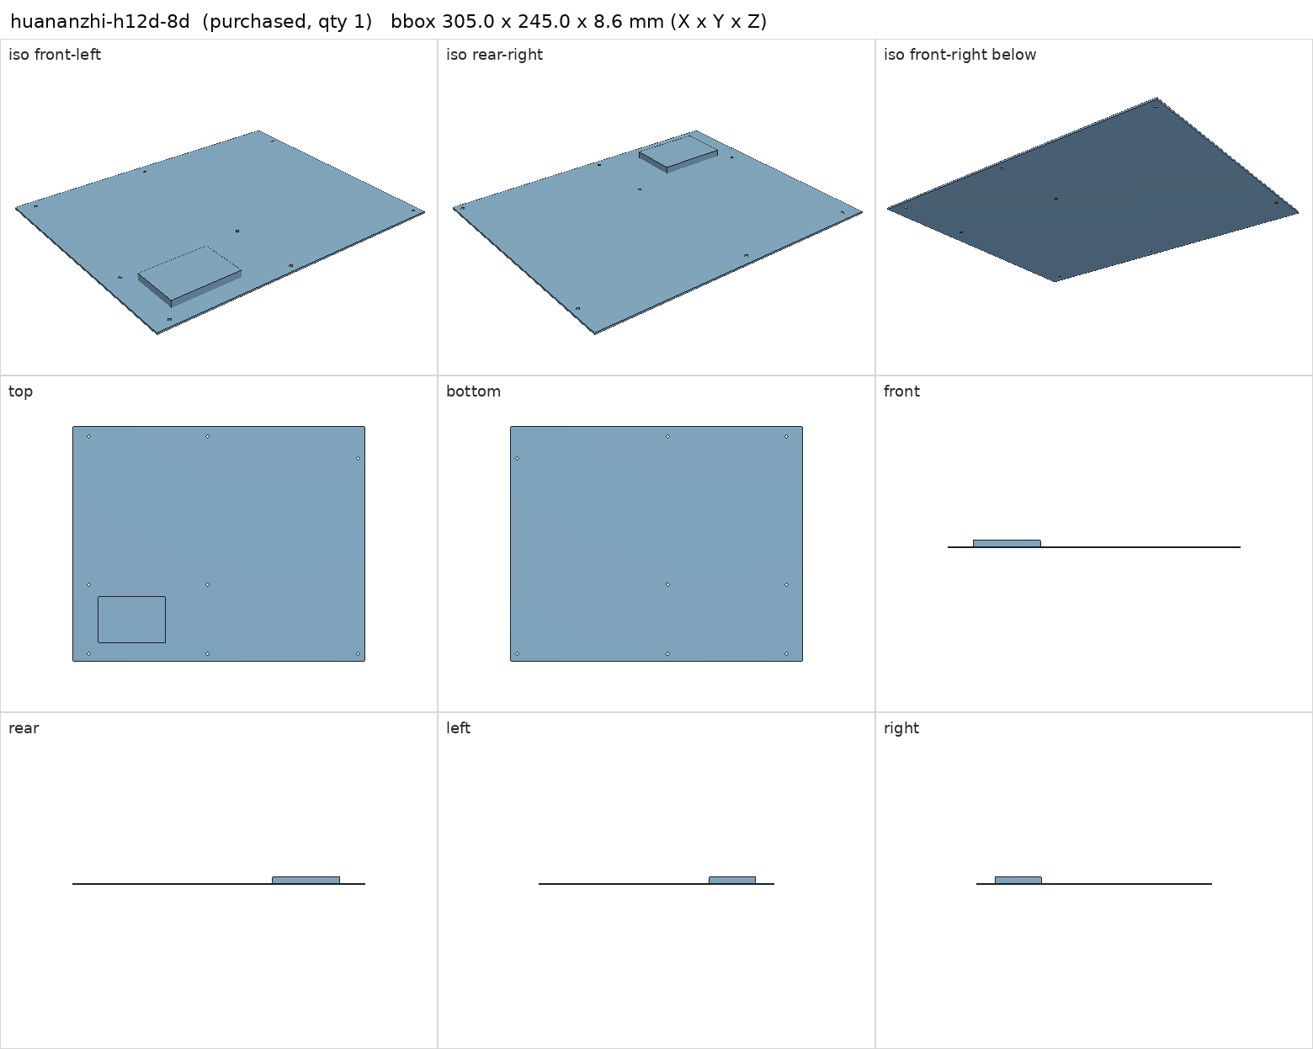
[picture p25: parts/purchased/huananzhi-h12d-8d/render.png]
Part views


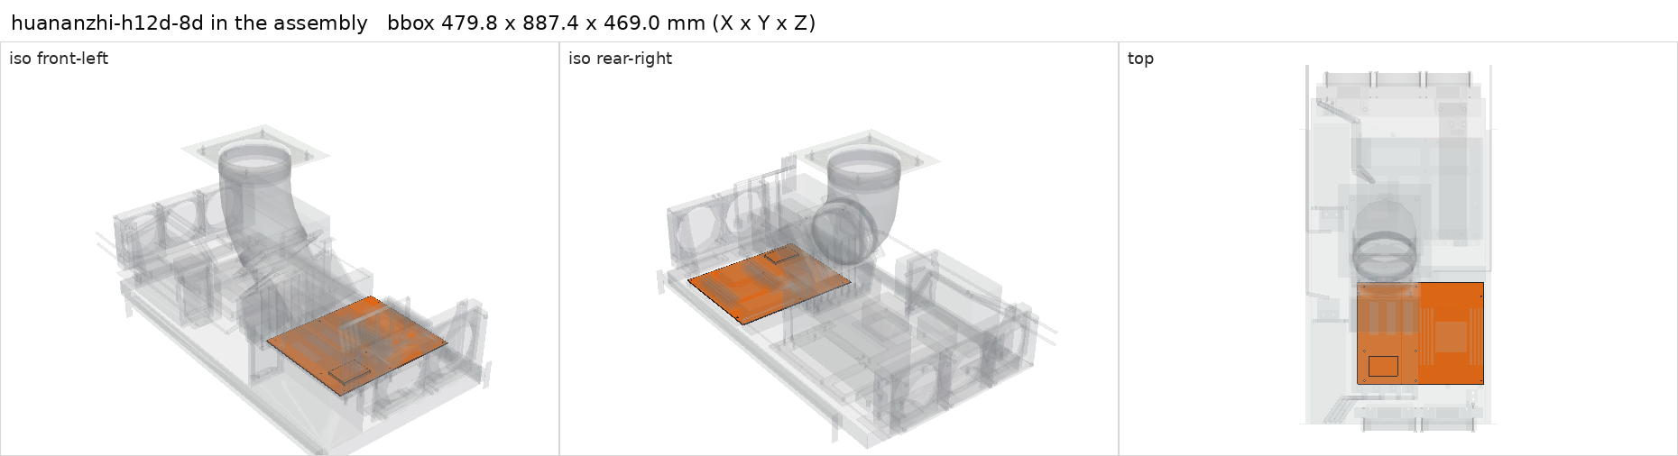
[picture p26: parts/purchased/huananzhi-h12d-8d/in-assembly.png]
Part in the assembly


## Model

- [huananzhi-h12d-8d.step](huananzhi-h12d-8d.step)
- Source: constructed. PCB plate plus BMC envelope; component positions photo-estimated.
- Assembly: 2 instances in the assembly

## Datasheets

- [HUANANZHI H12D-8D product page](https://www.huananzhi.com/en/list_6/177.html)
- [HUANANZHI H12D-8D user manual](https://www.huananzhi.com/uploads/file/20260212/1770877734213650.pdf)
- Local copies: `datasheets/` after `make datasheets` (not committed)

## Dimensions

| Key | Value | Evidence | Source / note |
| --- | --- | --- | --- |
| pcb_width | 305 mm | datasheet | product page: Dimension 305*245MM ATX |
| pcb_depth | 245 mm | datasheet | product page: Dimension 305*245MM ATX |
| pcb_thickness | 1.6 mm | assumed |  |
| mass | 1.2 kg | assumed |  |

## Interfaces

- provides `cpu-socket` value SP3 (datasheet)
- provides `memory-slot` value DDR4 RDIMM count 8 (datasheet) — product page: 8 x DDR4 slots, octa-channel
- provides `pcie-x16-slot` value PCIe x16 count 4 (datasheet) — product page: 4 x PCIe 4.0 x16; slot plane positions photo-estimated
- provides `pcie-card-envelope` max 40.64 (photo-estimate) — two-slot pitch 2 x 20.32 mm per PCIe CEM, but the slot positions are photo-estimated; confirm in the user manual
- provides `m2-slot` value M.2 2280 NVMe count 3 (datasheet) — three PCIe 4.0 x4 slots per manufacturer page
- provides `sff-8643-port` accepts ['PCIe 4.0 x4 U.2', '4 x SATA 6Gb/s'] count 3 (datasheet) — product page: 3 x SFF-8643 supports expand 12 x SATA3.0 6Gbps or 3 x PCIE4.0 x4 U.2; manual spec list: 3xMINISAS(SATA*4&PCIE3.0/4.0X4). Neither document says how a port is switched between SATA and PCIe (BIOS, jumper or auto-detect) or whether two ports can be grouped as x8; connector positions are photo-estimated from the manual layout figure only. Candidate host for a cabled PCIe riser and NIC, since all four x16 slots carry V100s
- provides `sata-port` value SATA 6Gb/s count 4 (datasheet) — product page: 4xSATA3.0 6Gbps; separate from the SFF-8643 SATA mode
- provides `usb2-header` count **unknown** (listing) — internal USB 2.0 header not listed on the product page; check the manual or board
- requires `board-standoff` value #6-32 F/F count 8 (photo-estimate) — populated sites A/C/F/G/H/K/L/M
- requires `mobo-front-section` value ATX count 1 (listing)
- requires `mobo-rear-rail` value H12D-8D slot positions count 1 (listing)
- requires `atx-24pin` count 1 (datasheet) — product page: 24PIN+8PIN+8PIN
- requires `eps-8pin-cpu` count 2 (datasheet) — product page: 24PIN+8PIN+8PIN
- requires `dc-power` load 60 (assumed) — board, BMC and chipset allowance

## Compatibility checks

| Status | Rule | Interface | Detail |
| --- | --- | --- | --- |
| BLOCKED | count | `usb2-header` | need 1 x usb2-header, have None |
| provisional | count | `atx-24pin` | need 1 x atx-24pin, have 1 |
| provisional | value | `board-standoff` | huananzhi-h12d-8d needs #6-32 F/F; provided by keystone-1451b |
| provisional | count | `board-standoff` | need 17 x board-standoff=#6-32 f/f, have 17 |
| provisional | budget | `dc-power` | load 1096.0 W of 1600.0 W x derate 0.8 = 1280.0 W (68% of rating); relies on configured limits of ['nvidia-v100-pcie-16gb']; unlimited peak 1376.0 W |
| provisional | count | `eps-8pin-cpu` | need 2 x eps-8pin-cpu, have 2 |
| provisional | value | `m2-slot` | micron-3400-2tb needs M.2 2280 NVMe; provided by huananzhi-h12d-8d |
| provisional | value | `m2-slot` | micron-3500-2tb needs M.2 2280 NVMe; provided by huananzhi-h12d-8d |
| provisional | count | `m2-slot` | need 3 x m2-slot=m.2 2280 nvme, have 3 |
| provisional | value | `memory-slot` | micron-mta36asf4g72pz-2g9 needs DDR4 RDIMM; provided by huananzhi-h12d-8d |
| provisional | count | `memory-slot` | need 8 x memory-slot=ddr4 rdimm, have 8 |
| provisional | value | `mobo-front-section` | huananzhi-h12d-8d needs ATX; provided by atx_mobo_adapter_front |
| provisional | count | `mobo-front-section` | need 2 x mobo-front-section=atx, have 2 |
| provisional | value | `mobo-rear-rail` | huananzhi-h12d-8d needs H12D-8D slot positions; provided by h12d_mobo_adapter_rail |
| provisional | count | `mobo-rear-rail` | need 1 x mobo-rear-rail=h12d-8d slot positions, have 1 |
| provisional | value | `pcie-card-envelope` | nvidia-v100-pcie-16gb needs 40.0; provided by huananzhi-h12d-8d |
| provisional | value | `sff-8643-port` | sff-8643-pcie-cable needs PCIe x4 device; provided by linkreal-lrfc6911n |
| provisional | count | `sff-8643-port` | need 1 x sff-8643-port=pcie x4 device, have 1 |
| provisional | budget | `shelf-load` | load 23.7 kg of 39.0 kg x derate 1.0 = 39.0 kg (61% of rating) |
| pass | value | `cpu-socket` | amd-epyc-7702p needs SP3; provided by huananzhi-h12d-8d |
| pass | value | `pcie-x16-slot` | nvidia-v100-pcie-16gb needs PCIe x16; provided by huananzhi-h12d-8d |
| pass | count | `pcie-x16-slot` | need 4 x pcie-x16-slot=pcie x16, have 4 |
| pass | value | `sff-8643-port` | sff-8643-pcie-cable needs PCIe 4.0 x4 U.2; provided by huananzhi-h12d-8d |
| pass | count | `sff-8643-port` | need 1 x sff-8643-port=pcie 4.0 x4 u.2, have 3 |
