cloudrift-ai/aipc/parts/purchased/linkreal-lrfc6911n/README.md

# Linkreal (LR-Link) LRFC6911N, 1 x SFF-8643 to PCIe x16 slot (x4) adapter

<!-- Generated by make check from part.toml. Edit part.toml, not this file. -->

| | |
| --- | --- |
| ID | `linkreal-lrfc6911n` |
| Category | purchased |
| Role | Berserk NIC slot: takes an H12D-8D SFF-8643 PCIe x4 port and provides an x16 slot for the ConnectX |
| Status | selected |
| Quantity | 1 |
| Systems | berserk |
| Product | <https://lr-link.com/products/lrfc6911.html> |
| Listing | <https://www.newegg.com/p/17Z-00TX-000C5> |

Chosen 2026-11-10, to be bought from Newegg (about $26, ships from China); not
ordered yet. It replaces the Delock 64173 candidate: that riser was listed as
PCIe 4.0 but was on backorder at the only US seller found, and the ConnectX-4
Lx is PCIe 3.0, so a Gen3 board is enough.
LR-Link does not state a PCIe generation; the Newegg Business listing of the
same 6911 board says PCIe 3.0 x4. Power is a SATA 15-pin socket, which leaves
the Hercules's Molex leads for the fan harness.
The LR-Link spec table gives 121 x 114.10 mm and 45.5 g; a search summary
quoting 120 x 42 mm did not match the page. Measure the board and its hole
positions on arrival before designing the holder.
The board has no bracket. It needs a printed holder and a place on the shelf,
and the NIC on it needs 300 LFM.

## Model

- Source: constructed
- Assembly: **not in the assembly**: shelf location and holder not designed yet; must clear the V100s and the BMC and leave airflow over the NIC

## Datasheets

- [LR-Link LRFC6911 product page](https://lr-link.com/products/lrfc6911.html)
- Local copies: `datasheets/` after `make datasheets` (not committed)

## Dimensions

| Key | Value | Evidence | Source / note |
| --- | --- | --- | --- |
| length | 121 mm | datasheet | LR-Link spec table: Dimensions 121mm*114.10mm |
| width | 114.1 mm | datasheet | LR-Link spec table: Dimensions 121mm*114.10mm |
| mass | 0.0455 kg | datasheet | LR-Link spec table: Weight 45.5g |

## Interfaces

- provides `sff-8643-port` value PCIe x4 device count 1 (listing) — LR-Link: Mini-SAS HD 4i socket connector (SFF-8643)
- provides `pcie-x4-slot` value PCIe x8 card, x4 link count 1 (listing) — LR-Link: 1*PCIe X16 Slot (X4 Bandwidth); LR-Link lists network cards among supported devices
- requires `sata-power` count 1 (listing) — LR-Link: 1x SATA 15 Pin Power Interface, 12V & 3.3V 5A; feeds the slot's 12 V and 3.3 V for the NIC

## Compatibility checks

| Status | Rule | Interface | Detail |
| --- | --- | --- | --- |
| BLOCKED | count | `sata-power` | need 1 x sata-power, have None |
| provisional | value | `pcie-x4-slot` | nvidia-mcx4131a-gcat needs PCIe x8 card, x4 link; provided by gigabyte-x870e-aorus-pro, linkreal-lrfc6911n |
| provisional | count | `pcie-x4-slot` | need 2 x pcie-x4-slot=pcie x8 card, x4 link, have 3 |
| provisional | value | `sff-8643-port` | sff-8643-pcie-cable needs PCIe x4 device; provided by linkreal-lrfc6911n |
| provisional | count | `sff-8643-port` | need 1 x sff-8643-port=pcie x4 device, have 1 |
| provisional | budget | `shelf-load` | load 23.7 kg of 39.0 kg x derate 1.0 = 39.0 kg (61% of rating) |
| pass | value | `sff-8643-port` | sff-8643-pcie-cable needs PCIe 4.0 x4 U.2; provided by huananzhi-h12d-8d |
| pass | count | `sff-8643-port` | need 1 x sff-8643-port=pcie 4.0 x4 u.2, have 3 |
