cloudrift-ai/aipc/parts/purchased/moddiy-eps-90-extension/README.md

# Low-profile 90 degree CPU/EPS 8-pin extension

<!-- Generated by make check from part.toml. Edit part.toml, not this file. -->

| | |
| --- | --- |
| ID | `moddiy-eps-90-extension` |
| Category | purchased |
| Role | keeps V100 power plugs low and clear of the front radiator |
| Status | selected |
| Quantity | 4 |
| Systems | berserk |

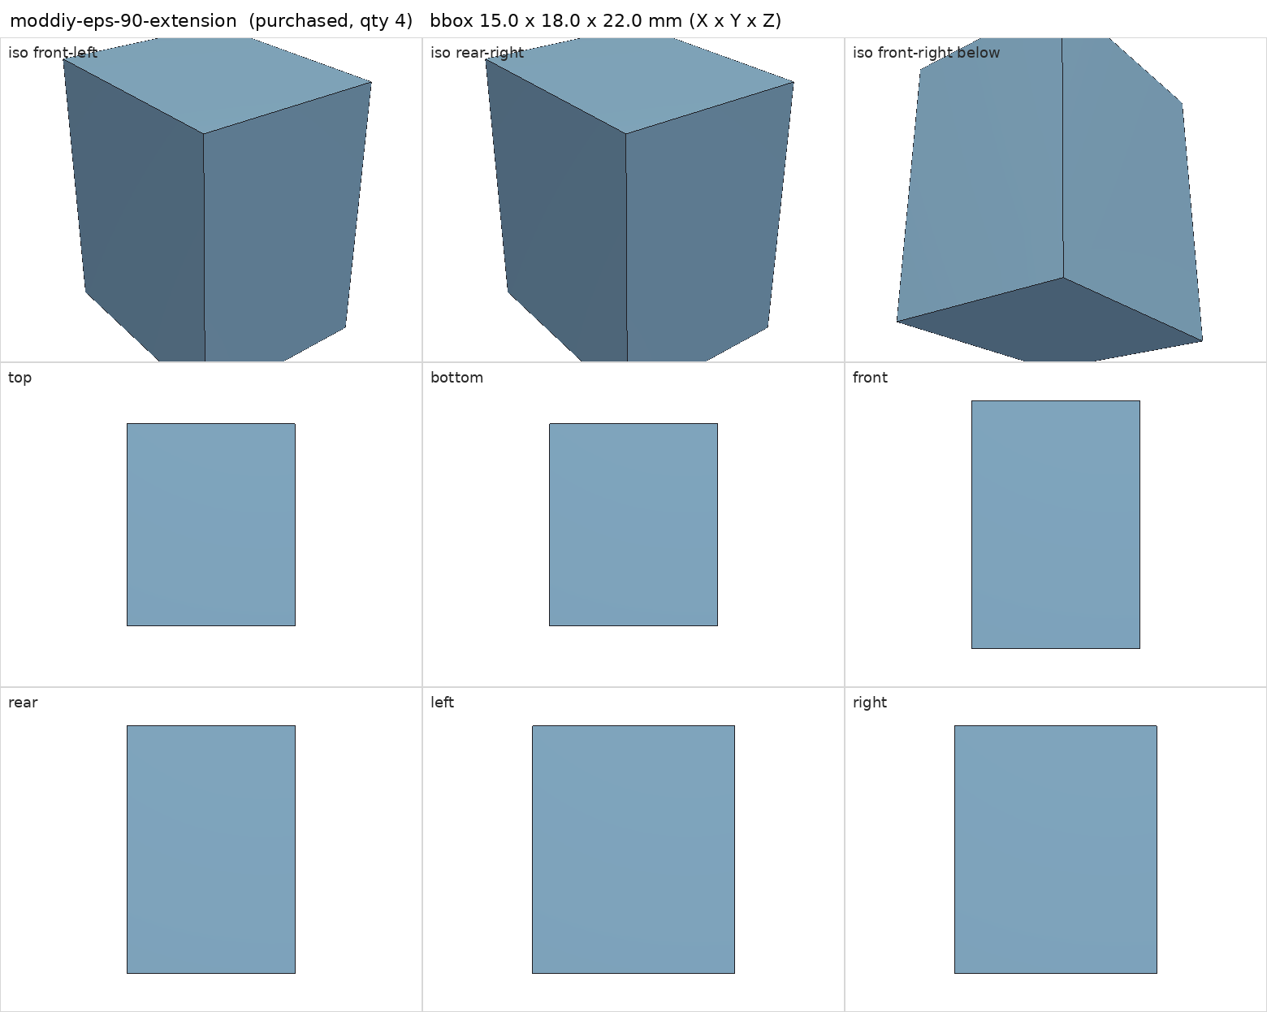
[picture p37: parts/purchased/moddiy-eps-90-extension/render.png]
Part views


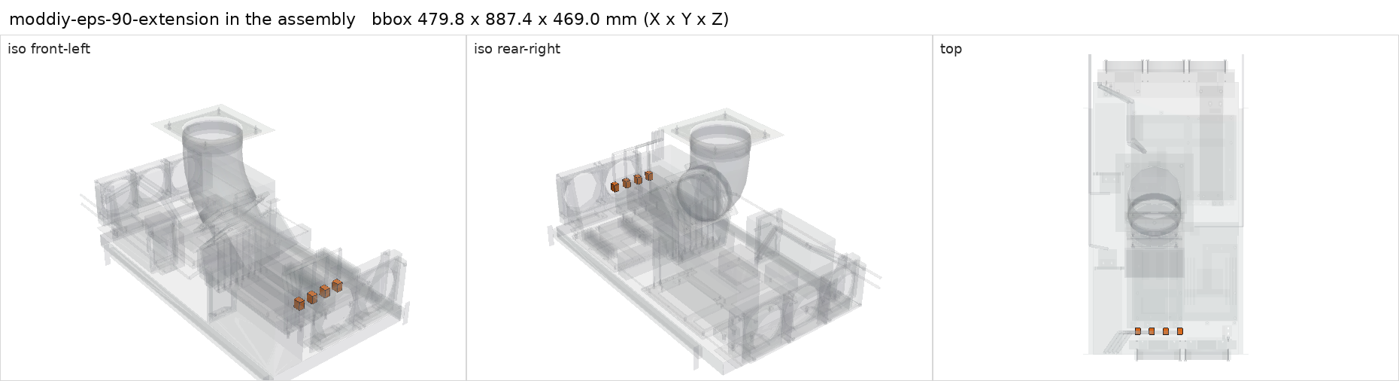
[picture p38: parts/purchased/moddiy-eps-90-extension/in-assembly.png]
Part in the assembly


## Model

- [moddiy-eps-90-extension.step](moddiy-eps-90-extension.step)
- Source: constructed. 15 x 18 x 22 mm plug target per card.
- Assembly: 4 instances in the assembly

## Datasheets

- None recorded. MODDIY product page not recorded; the 18 mm projection is a design target, not a product dimension.

## Dimensions

| Key | Value | Evidence | Source / note |
| --- | --- | --- | --- |
| projection | 18 mm | allowance |  |
| mass | 0.02 kg | assumed |  |

## Compatibility checks

| Status | Rule | Interface | Detail |
| --- | --- | --- | --- |
| provisional | budget | `shelf-load` | load 23.7 kg of 39.0 kg x derate 1.0 = 39.0 kg (61% of rating) |
