cloudrift-ai/aipc/parts/purchased/nvidia-mcx4131a-gcat/README.md

# NVIDIA (Mellanox) ConnectX-4 Lx EN MCX4131A-GCAT, 50GbE single-port QSFP28

<!-- Generated by make check from part.toml. Edit part.toml, not this file. -->

| | |
| --- | --- |
| ID | `nvidia-mcx4131a-gcat` |
| Category | purchased |
| Role | Direct Berserk-Kenshin link over a QSFP28 DAC (one card per system) |
| Status | owned |
| Quantity | 2 |
| Systems | berserk, kenshin |
| Manual | <https://networking-docs.nvidia.com/connectx4lxhw/> |

Owned, two cards (owner, 2026-11-10); serial numbers, firmware and bracket
height not yet recorded. One goes in each PC, cabled directly with no switch.
PCIe 3.0 x8 card. Berserk has no free x16 slot (four V100s), so its card sits
in a Linkreal LRFC6911N riser fed from an H12D-8D SFF-8643 port (x4). Kenshin's
card goes in a chipset PCIEX4 slot (x4). Both links therefore train at
PCIe 3.0 x4 (about 31.5 Gb/s raw, roughly 25-28 Gb/s usable), below the
50GbE line rate.
Each card's systems entry covers both PCs, so the compatibility check lists
the NIC's power and slot rules as a separate group from each system's other
loads. Kenshin's PCIEX4 slots may sit under the RTX 5090 cooler; check that
before relying on them.
The card has a passive heatsink and needs 300 LFM across it (manual airflow
table). Neither placement has forced airflow yet.
NVIDIA lists the ConnectX-4 Lx line as end of life.

## Model

- Source: constructed
- Assembly: **not in the assembly**: card positions not chosen: Berserk's sits on a riser whose shelf location is open, and Kenshin's PCIEX4 slot clearance under the RTX 5090 is unchecked

## Datasheets

- [ConnectX-4 Lx Ethernet adapter cards user manual: specifications](https://networking-docs.nvidia.com/connectx4lxhw/specifications)
- Local copies: `datasheets/` after `make datasheets` (not committed)

## Dimensions

| Key | Value | Evidence | Source / note |
| --- | --- | --- | --- |
| card_height | 68.9 mm | datasheet | manual specifications: 2.71 in. x 5.6 in. (68.90mm x 142.24 mm) - low profile |
| card_length | 142.24 mm | datasheet | manual specifications: 2.71 in. x 5.6 in. (68.90mm x 142.24 mm) - low profile |
| power_typical | 9.6 W | datasheet | manual specifications: typical power, passive cables |
| power_max | 11.6 W | datasheet | manual specifications: maximum power, passive cables |
| airflow | 300 LFM | datasheet | manual airflow table, 40/50Gb/s, passive cable, either direction |
| mass | 0.15 kg | assumed |  |

## Interfaces

- provides `qsfp28-port` value QSFP28 50GbE count 1 (datasheet) — manual: Single QSFP28 (copper and optical); 50G-R2 and 50GBASE-R4 listed
- requires `pcie-x4-slot` value PCIe x8 card, x4 link count 1 (datasheet) — x8 edge connector, PCIe 3.0 8 GT/s; needs an open-ended or x16 physical slot; x4 electrical trains at x4
- requires `qsfp28-dac` value QSFP28 passive DAC, 50GbE count 1 (allowance) — one cable end per card; a passive DAC keeps power at the 11.6 W figure. Cable not chosen; length depends on where the two cards end up
- requires `pcie-card-airflow` value 300 (datasheet) — 300 LFM over the heatsink with passive cables; nothing in either system is specified to provide it yet
- requires `dc-power` load 11.6 W (datasheet) — maximum with passive cables, 12 V and 3.3 V; Berserk's comes through the riser

## Compatibility checks

| Status | Rule | Interface | Detail |
| --- | --- | --- | --- |
| BLOCKED | presence | `pcie-card-airflow` | nothing in systems ['berserk', 'kenshin'] provides 'pcie-card-airflow' |
| BLOCKED | presence | `qsfp28-dac` | nothing in systems ['berserk', 'kenshin'] provides 'qsfp28-dac' |
| provisional | budget | `dc-power` | load 23.2 W of 2800.0 W x derate 0.8 = 2240.0 W (1% of rating) |
| provisional | value | `pcie-x4-slot` | nvidia-mcx4131a-gcat needs PCIe x8 card, x4 link; provided by gigabyte-x870e-aorus-pro, linkreal-lrfc6911n |
| provisional | count | `pcie-x4-slot` | need 2 x pcie-x4-slot=pcie x8 card, x4 link, have 3 |
| provisional | budget | `shelf-load` | load 23.7 kg of 39.0 kg x derate 1.0 = 39.0 kg (61% of rating) |
