cloudrift-ai/aipc/parts/purchased/nvidia-v100-pcie-16gb/README.md

# NVIDIA Tesla V100 PCIe 16 GB

<!-- Generated by make check from part.toml. Edit part.toml, not this file. -->

| | |
| --- | --- |
| ID | `nvidia-v100-pcie-16gb` |
| Category | purchased |
| Role | Berserk GPUs (passive, ducted) |
| Status | selected |
| Quantity | 4 |
| Systems | berserk |
| Listing | <https://www.ebay.com/itm/127840399241> |

Passive 250 W cards: they need forced ducted airflow. Auxiliary power is a
CPU/EPS 8-pin connector; never plug PCIe 8-pin into it. Start near 180 W per
card. Thickness, slot offset and flange holes are provisional.

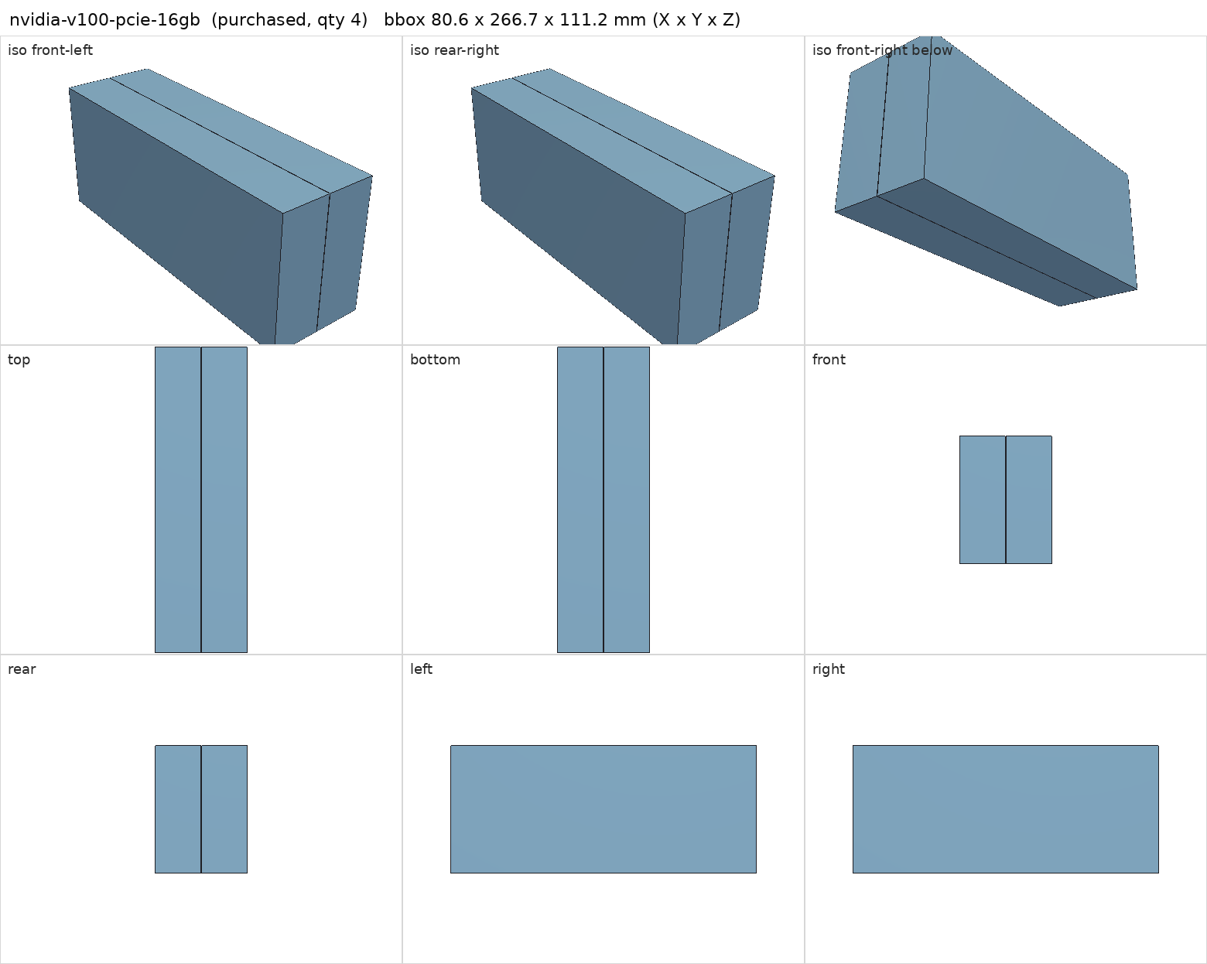
[picture p39: parts/purchased/nvidia-v100-pcie-16gb/render.png]
Part views


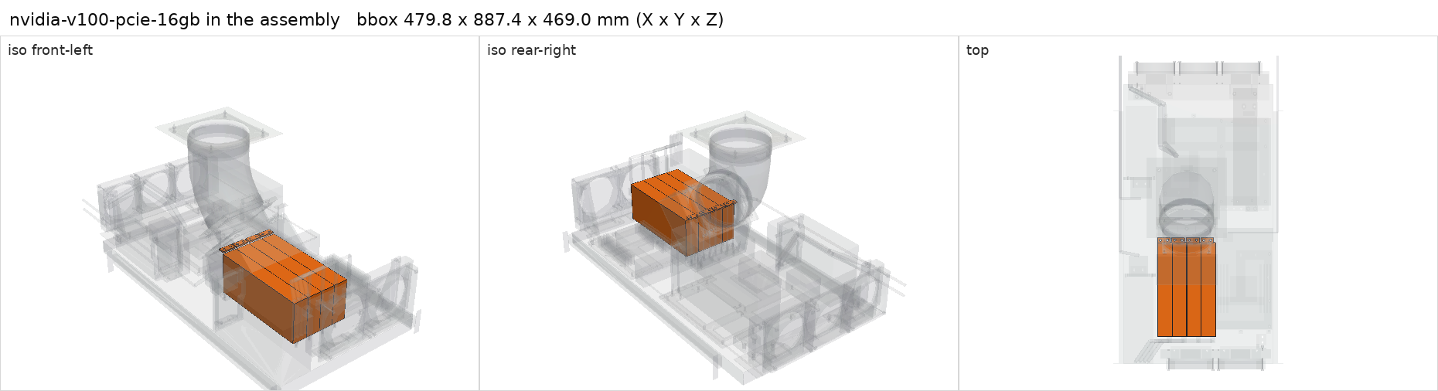
[picture p40: parts/purchased/nvidia-v100-pcie-16gb/in-assembly.png]
Part in the assembly


## Model

- [nvidia-v100-pcie-16gb.step](nvidia-v100-pcie-16gb.step)
- Source: constructed. Body envelope plus bracket-flange hole survey.
- Assembly: 8 instances in the assembly

## Datasheets

- [Tesla V100 PCIe product brief](https://www.nvidia.com/content/dam/en-zz/Solutions/Data-Center/tesla-product-literature/Tesla-V100-PCIe-Product-Brief.pdf)
- Local copies: `datasheets/` after `make datasheets` (not committed)

## Dimensions

| Key | Value | Evidence | Source / note |
| --- | --- | --- | --- |
| length | 266.7 mm | datasheet | product brief |
| height | 111.15 mm | datasheet | product brief |
| thickness | 40 mm | allowance | dual-slot nominal; 36 mm component side + 4 mm back side assumed |
| tgp | 250 W | datasheet | product brief |
| mass | 1.196 kg | datasheet | product brief p.3, board 1196 g |

## Interfaces

- requires `pcie-x16-slot` value PCIe x16 count 1 (datasheet) — PCIe 3.0 card in a PCIe 4.0 slot
- requires `pcie-card-envelope` value 40 (allowance)
- requires `v100-aux-power` value CPU/EPS 8-pin count 1 (datasheet)
- requires `gpu-forced-airflow` count 1 (datasheet)
- requires `dc-power` load 250 load_limited 180 (datasheet) — nvidia-smi power limit 180 W planned for first runs

## Compatibility checks

| Status | Rule | Interface | Detail |
| --- | --- | --- | --- |
| provisional | budget | `dc-power` | load 1096.0 W of 1600.0 W x derate 0.8 = 1280.0 W (68% of rating); relies on configured limits of ['nvidia-v100-pcie-16gb']; unlimited peak 1376.0 W |
| provisional | count | `gpu-forced-airflow` | need 4 x gpu-forced-airflow, have 4 |
| provisional | value | `pcie-card-envelope` | nvidia-v100-pcie-16gb needs 40.0; provided by huananzhi-h12d-8d |
| provisional | budget | `shelf-load` | load 23.7 kg of 39.0 kg x derate 1.0 = 39.0 kg (61% of rating) |
| provisional | value | `v100-aux-power` | nvidia-v100-pcie-16gb needs CPU/EPS 8-pin; provided by v100-eps-power-adapter |
| provisional | count | `v100-aux-power` | need 4 x v100-aux-power=cpu/eps 8-pin, have 4 |
| pass | value | `pcie-x16-slot` | nvidia-v100-pcie-16gb needs PCIe x16; provided by huananzhi-h12d-8d |
| pass | count | `pcie-x16-slot` | need 4 x pcie-x16-slot=pcie x16, have 4 |
