cloudrift-ai/aipc/parts/purchased/samsung-990-pro-4tb/README.md

# Samsung 990 PRO 4 TB NVMe

<!-- Generated by make check from part.toml. Edit part.toml, not this file. -->

| | |
| --- | --- |
| ID | `samsung-990-pro-4tb` |
| Category | purchased |
| Role | Kenshin storage |
| Status | owned |
| Quantity | 2 |
| Systems | kenshin |

## Model

- Source: constructed
- Assembly: **not in the assembly**: X870E M.2 slot positions not surveyed; drives sit under the board heatsinks

## Datasheets

- [Samsung 990 PRO](https://semiconductor.samsung.com/consumer-storage/internal-ssd/990-pro/)
- Local copies: `datasheets/` after `make datasheets` (not committed)

## Dimensions

| Key | Value | Evidence | Source / note |
| --- | --- | --- | --- |
| mass | 0.009 kg | assumed |  |

## Interfaces

- requires `m2-slot` value M.2 2280 NVMe count 1 (datasheet)
- requires `dc-power` load 9 (assumed)

## Compatibility checks

| Status | Rule | Interface | Detail |
| --- | --- | --- | --- |
| provisional | budget | `dc-power` | load 908.0 W of 1200.0 W x derate 0.8 = 960.0 W (76% of rating) |
| provisional | value | `m2-slot` | samsung-990-pro-4tb needs M.2 2280 NVMe; provided by gigabyte-x870e-aorus-pro |
| provisional | count | `m2-slot` | need 2 x m2-slot=m.2 2280 nvme, have 4 |
| provisional | budget | `shelf-load` | load 23.7 kg of 39.0 kg x derate 1.0 = 39.0 kg (61% of rating) |
