cloudrift-ai/aipc/parts/purchased/sanyo-denki-9gv1412p1s001/README.md

# Sanyo Denki San Ace 9GV1412P1S001 140 x 38 mm fan

<!-- Generated by make check from part.toml. Edit part.toml, not this file. -->

| | |
| --- | --- |
| ID | `sanyo-denki-9gv1412p1s001` |
| Category | purchased |
| Role | pressure fan pulling air through the four V100s |
| Status | selected |
| Quantity | 1 |
| Systems | berserk |

12 V, 3.1 A, 37.2 W at 100% PWM; 272 CFM, 480 Pa (catalog p.185). Motor fed from the PSU by fan-power-harness; PWM from the QUADRO. An open PWM line runs it at 100%.

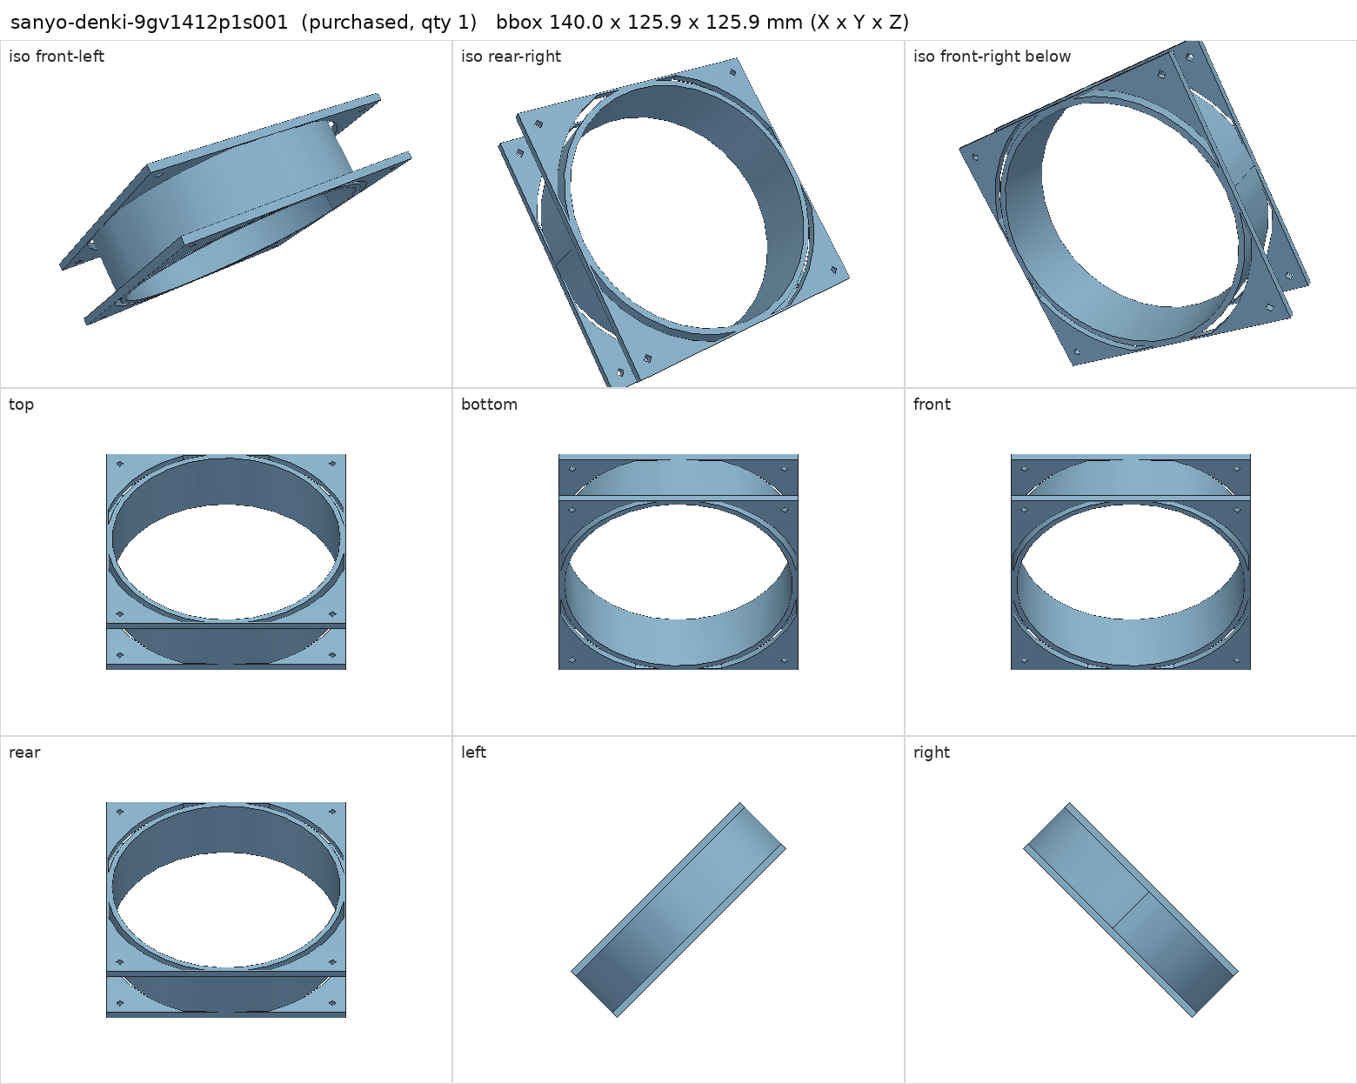
[picture p45: parts/purchased/sanyo-denki-9gv1412p1s001/render.png]
Part views


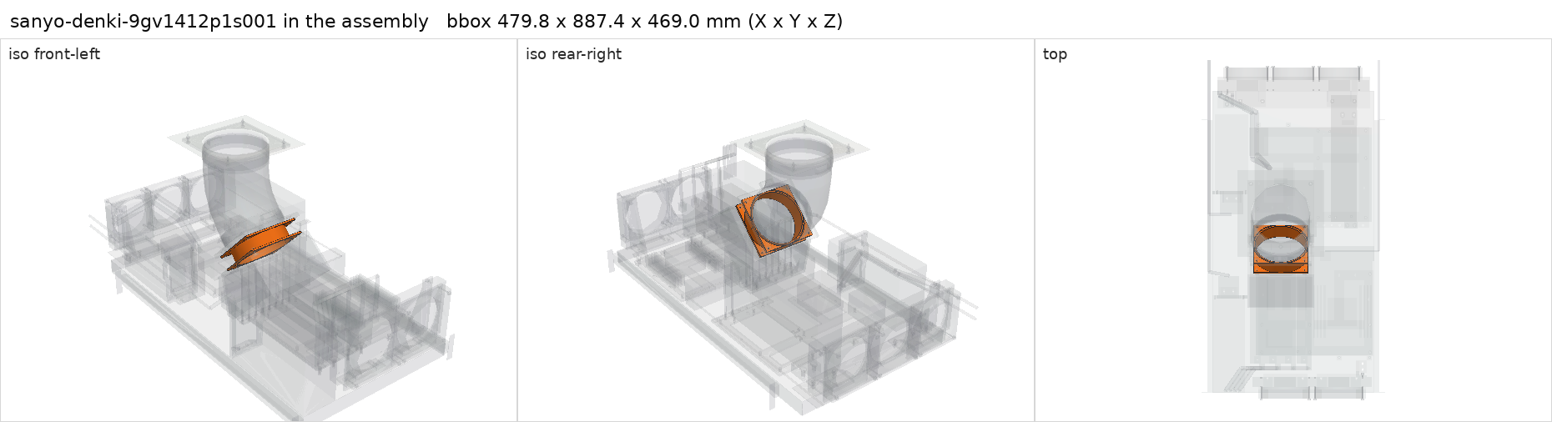
[picture p46: parts/purchased/sanyo-denki-9gv1412p1s001/in-assembly.png]
Part in the assembly


## Model

- [sanyo-denki-9gv1412p1s001.step](sanyo-denki-9gv1412p1s001.step)
- Source: constructed. Body envelope tilted 45 degrees on the hood panel.
- Vendor CAD: https://products.sanyodenki.com/en/sanace/dc/ (CAD after registration)
- Assembly: 1 instances in the assembly

## Datasheets

- [San Ace catalog, pp. 185-188](https://publish.sanyodenki.com/San_Ace_E/book/data/San_Ace_E.pdf)
- Local copies: `datasheets/` after `make datasheets` (not committed)

## Dimensions

| Key | Value | Evidence | Source / note |
| --- | --- | --- | --- |
| size | 140 mm | datasheet | San Ace catalog |
| depth | 38 mm | datasheet | San Ace catalog |
| hole_pitch | 124.5 mm | datasheet | San Ace catalog |
| current | 3.1 A | datasheet | San Ace catalog |
| mass | 0.63 kg | datasheet | San Ace catalog p.185, 630 g |

## Interfaces

- provides `gpu-forced-airflow` count 4 (allowance) — free-air rating; loaded airflow through the hood unqualified
- requires `fan-mount` value 140 mm, 124.5 mm pitch count 2 (datasheet) — inlet on the hood panel, outlet on the exhaust flange
- requires `fan-power` value 12 V PWM 4-wire, 3.1 A count 1 (datasheet)
- requires `dc-power` load 37.2 (datasheet)

## Compatibility checks

| Status | Rule | Interface | Detail |
| --- | --- | --- | --- |
| provisional | budget | `dc-power` | load 1096.0 W of 1600.0 W x derate 0.8 = 1280.0 W (68% of rating); relies on configured limits of ['nvidia-v100-pcie-16gb']; unlimited peak 1376.0 W |
| provisional | value | `fan-mount` | sanyo-denki-9gv1412p1s001 needs 140 mm, 124.5 mm pitch; provided by gpu_exhaust_fan_flange, v100_gpu_shroud |
| provisional | count | `fan-mount` | need 2 x fan-mount=140 mm, 124.5 mm pitch, have 2 |
| provisional | value | `fan-power` | sanyo-denki-9gv1412p1s001 needs 12 V PWM 4-wire, 3.1 A; provided by fan-power-harness |
| provisional | count | `fan-power` | need 1 x fan-power=12 v pwm 4-wire, 3.1 a, have 1 |
| provisional | count | `gpu-forced-airflow` | need 4 x gpu-forced-airflow, have 4 |
| provisional | budget | `shelf-load` | load 23.7 kg of 39.0 kg x derate 1.0 = 39.0 kg (61% of rating) |
