cloudrift-ai/aipc/parts/purchased/sff-8643-pcie-cable/README.md

# 10Gtek CAB-8643/8643-P0.5M, SFF-8643 to SFF-8643 cable, 0.5 m, with sideband (2-pack)

<!-- Generated by make check from part.toml. Edit part.toml, not this file. -->

| | |
| --- | --- |
| ID | `sff-8643-pcie-cable` |
| Category | purchased |
| Role | PCIe x4 link from an H12D-8D SFF-8643 port to the Linkreal LRFC6911N riser |
| Status | selected |
| Quantity | 1 |
| Systems | berserk |
| Listing | <https://www.newegg.com/10Gtek-SCSI-SAS-InfiniBand-Cables/BrandSubCat/ID-137698-2835> |
| Ebay | <https://www.ebay.com/itm/405447883263> |

Chosen 2026-11-10, to be bought from Newegg (2-pack, about $22.59 on a listing
that may be stale); not ordered yet. One cable is used and the other is kept
as a spare, so the quantity here is 1.
Straight male-to-male, not a reverse or breakout cable. The ConnectX-4 Lx
link is PCIe 3.0, which a short 12G SAS-grade cable with sideband normally
carries. If the link shows errors, set the port to Gen3 in the BIOS. No
straight SFF-8643 cable rated for PCIe 4.0 was found.

## Model

- Source: constructed
- Assembly: **not in the assembly**: cable route follows the riser location, which is not chosen yet

## Datasheets

- None recorded. Marketplace cable; 10Gtek publishes no drawing or PCIe rating for it. Listings give 12G SAS, 100 ohm, 30 AWG, sideband.

## Dimensions

| Key | Value | Evidence | Source / note |
| --- | --- | --- | --- |
| length | 500 mm | listing | eBay listing: CAB-8643/8643-P0.5M, 0.5 m |
| mass | 0.05 kg | assumed |  |

## Interfaces

- requires `sff-8643-port` value PCIe 4.0 x4 U.2 count 1 (datasheet) — host end on an H12D-8D SFF-8643 port set to PCIe mode
- requires `sff-8643-port` value PCIe x4 device count 1 (listing) — device end on the riser

## Compatibility checks

| Status | Rule | Interface | Detail |
| --- | --- | --- | --- |
| provisional | value | `sff-8643-port` | sff-8643-pcie-cable needs PCIe x4 device; provided by linkreal-lrfc6911n |
| provisional | count | `sff-8643-port` | need 1 x sff-8643-port=pcie x4 device, have 1 |
| provisional | budget | `shelf-load` | load 23.7 kg of 39.0 kg x derate 1.0 = 39.0 kg (61% of rating) |
| pass | value | `sff-8643-port` | sff-8643-pcie-cable needs PCIe 4.0 x4 U.2; provided by huananzhi-h12d-8d |
| pass | count | `sff-8643-port` | need 1 x sff-8643-port=pcie 4.0 x4 u.2, have 3 |
