cloudrift-ai/aipc/parts/purchased/mains-power/README.md

# Mains circuit, UPS and PDU (not specified)

<!-- Generated by make check from part.toml. Edit part.toml, not this file. -->

| | |
| --- | --- |
| ID | `mains-power` |
| Category | purchased |
| Role | AC supply for both PSUs |
| Status | unspecified |
| Quantity | 1 |
| Systems | rack |

Both systems at full load draw about 2.5 kW from the wall, more than one
15 A / 120 V circuit carries continuously (1.44 kW). Record the circuit(s),
UPS and PDU ratings and outlet types (C13/C19) here.

## Model

- Source: constructed
- Assembly: **not in the assembly**: outside the shelf; supply not specified

## Datasheets

- None recorded. 

## Interfaces

- provides `ac-power` capacity **unknown** W (unknown)

## Compatibility checks

| Status | Rule | Interface | Detail |
| --- | --- | --- | --- |
| BLOCKED | budget | `ac-power` | load 2531.0 W; capacity unknown |
