cloudrift-ai/aipc/parts.xlsx

Sheet: Shelf
Item | Qty | Unit | Unit price (USD) | Total (USD) | Link | More links | Notes
Hammond RSUS1931BK1 sliding shelf | 1 | each |  |  | Hammond (https://www.hammfg.com/part/RSUS1931BK1) | Specifications (https://www.hammfg.com/dci/products/accessories/rsus) | Selected 2026-11-05; not confirmed ordered; price pending. Deck 422.656 × 787.4 mm; included slides, 711.2 mm travel. Current table: 39 kg load, 457.2–711.2 mm rack-post spacing, 2U mount / 3U clearance. Measure rack and underside before drilling. Replaces StarTech / King Slide adaptation; no shims.
Keystone 1451B #6-32 F/F brass standoff, 3/8 in (9.53 mm) | 17 | each | $0.88 |  | DigiKey (https://www.digikey.com/en/products/detail/keystone-electronics/1451B/303586) |  | Eight for the H12D, nine for the X870E. Fit only the board's populated holes; ground one standoff to the shelf.
Open Benchtable PCI-E support + nut, 2-pack | 5 | 2-pack | $10.00 |  | Open Benchtable (https://store.openbenchtable.com/products/obt-pci-e-thumbscrew-nut-pack) |  | Ten posts, two per GPU. Owner reports 9 mm male M3 tips; fixed lower-nut height needs dry-fit.
Würth 970140324 M3 F/F brass standoff, 14 mm | 10 | each | $0.64 |  | DigiKey (https://www.digikey.com/en/products/detail/w%C3%BCrth-elektronik/970140324/9488563) | Manufacturer drawing (https://www.we-online.com/components/products/datasheet/970140324.pdf) | Ten replacement bases, SW5.5, full M3 thread. Pass through plastic to steel. M3x8 below with two OD12x1 and two OD7x0.5 washers: 3.48 mm engagement, 1.52 mm gap to owner-reported 9 mm OBT stud at nominal 1.52 mm deck. Measure real stack. Existing DigiKey price checked 2026-10-23.
Shelf fasteners and backing washers | 45 | joints |  |  |  |  | 25 M4 joints and 20 M3 joints: ten adapter anchors (M3x16, OD7 top/back washers, nuts); ten GPU bases (M3x8, two OD7x0.5 + two OD12x1 underside washers per base). Thus GPU bases alone need 20 small + 20 large washers. See assembly guide. Factory shelf-to-rack hardware separate; measure rack.
Component fasteners and interface hardware | 1 | set |  |  |  |  | 17 low-head #6-32 standoff screws, PSU and radiator screws, four M4 × 20 mm F/F metal tail spacers with 4 mm silicone pads, nonconductive foam seal for the GPU hood.
AC power cords | 2 | each |  |  |  |  | Corsair: low-profile or down-exit C13. Rosewill: match its inlet and the UPS outlet (it may need C19).
Printed parts | 18 | each |  |  |  |  | 17 installed parts plus one fit coupon, on 14 plates. See print/README.md.
Rear AIO steel extension plate, 400 × 83 × 3 mm | 1 | each |  |  |  |  | Fabricate in mild steel, deburr and coat. Six Ø5 holes from rear-aio-steel-extension-report.json; six M4x20 joints also retain printed mounts and shelf. Supports rear overhang; adds 3 mm to mount height. Physical fit/load test pending.
Known total

Sheet: Berserk
Item | Qty | Unit | Unit price (USD) | Total (USD) | Link | More links | Notes
HUANANZHI H12D-8D + BMC with AMD EPYC 7702P (64 cores) | 1 | each | $1250.00 |  | eBay listing (https://www.ebay.com/itm/396800856844) | https://www.huananzhi.com/en/list_6/177.html | 305 × 245 mm SP3 board, four PCIe 4.0 x16 slots, eight memory channels. Installed 2026-11-07: PCB V2.0, BIOS 2.2, BMC firmware 1.01; the 7702P boots, so it is not vendor-locked. Two Intel I226-V 2.5GbE ports; the BMC port needs its own cable.
Micron 256 GB (8 × 32 GB) DDR4-2933 ECC RDIMM kit | 1 | kit |  |  | eBay listing (https://www.ebay.com/itm/377566838345) |  | INSTALLED 2026-11-07. Used matched kit, MTA36ASF4G72PZ-2G9E2UI, 2Rx4, 1.2 V. One DIMM per channel, all at 2933 MT/s, ECC active, no errors at first boot. Memory test pending. Paid price not provided.
NVIDIA Tesla V100 PCIe 16 GB | 4 | each |  |  | eBay (https://www.ebay.com/itm/327314931099) | https://www.ebay.com/itm/127840399241, https://www.nvidia.com/content/dam/en-zz/Solutions/Data-Center/tesla-product-literature/Tesla-V100-PCIe-Product-Brief.pdf | Price $244.99–359.99. Genuine PCIe cards, passive 250 W. Remove the OEM extenders. Start around 180 W per card.
V100 power adapter, dual PCIe 8-pin to CPU/EPS 8-pin (030-0571-000 compatible) | 4 | each | $20.90 |  | eBay (https://www.ebay.com/itm/256383020187) |  | Check the pinout against NVIDIA's brief before use. Never plug a PCIe 8-pin straight into a V100.
Low-profile 90° CPU/EPS 8-pin extension | 4 | each | $14.99 |  | MODDIY (https://www.moddiy.com/products/5840/CPU-EPS-90%C2%B0-L-Shape-Mini-Low-Profile-EPS-Power-Cable-8-Pin-Down-Angle.html) |  | Keeps the GPU power plugs low and clear of the front radiator. The CAD reserves 18 mm; verify the real projection and rating.
Sanyo Denki 9GV1412P1S001 fan, 140 × 140 × 38 mm | 1 | each | $82.26 |  | DigiKey (https://www.digikey.com/en/products/detail/sanyo-denki-america-inc/9GV1412P1S001/8284659) |  | Pulls air through all four V100 heatsinks via the printed hood. 12 V, 3.1 A.
Aquacomputer QUADRO fan controller (53256) + fused PWM pass-through harness | 1 | each |  |  | fan catalog (https://publish.sanyodenki.com/San_Ace_E/book/data/San_Ace_E.pdf) |  | QUADRO supplies 25 kHz PWM and tach only (25 W per channel is below the fan's 37.2 W). Motor runs from a PSU Molex lead through a 5 A fuse. Linux hwmon control from the hottest GPU; 49.90 EUR at Aquacomputer.
GPU fan and exhaust fasteners | 1 | set |  |  | T-nut example (https://www.amazon.ae/Sutemribor-Hammer-Fastener-Aluminum-Profile/dp/B07FPLZXTF) |  | 8 M4 2020 hammer T-nuts, 4 M4 × 14 and 4 M4 × 16 socket-cap screws, 8 OD9 × 1 washers; roof: 4 M4 × 20 bolts, 4 nuts, 8 OD12 × 1 washers.
McMaster 53185K52 lever-release hose clamp | 2 | each | $21.92 |  | McMaster (https://www.mcmaster.com/53185K52/) |  | One at each end of the duct.
6-inch wire-supported flexible duct | 1 | m |  |  |  |  | Uninsulated; trim after fitting.
2 mm silicone foam gasket sheet, 200 × 200 mm | 1 | each |  |  |  |  | Roof-flange seal.
Micron 3400 2 TB NVMe (MTFDKBA2T0TFH) | 2 | each | $205.95 |  | eBay listing (https://www.ebay.com/itm/880020201442) |  | Installed 2026-11-07. Ordered as three used Dell OEM 3400s; two 3400s (HP and Micron firmware) and one 3500 arrived. SMART clean (0% used). RAID 0 members; the array also holds the OS. SSD cooling/clearance under the V100s pending.
Micron 3500 2 TB NVMe (MTFDKBA2T0TGD) | 1 | each | $205.95 |  | eBay listing (https://www.ebay.com/itm/880020201442) |  | Installed 2026-11-07. Arrived in the 3400 order above in place of one 3400; HP OEM firmware HPS0050. SMART clean (0% used, 559 h). Third RAID 0 member.
Corsair Hydro H115i (280 mm AIO) | 1 | each |  |  |  |  | Reused. Mounts on SP3 with an Asetek TR4/SP3 bracket (to source; partial cold-plate coverage accepted 2026-11-06). Check hose reach.
Rosewill Hercules 1600 W PSU | 1 | each |  |  |  |  | Reused, with its own modular cables. Needs 24-pin, two EPS 8-pin and eight PCIe 8-pin feeds.
NVIDIA ConnectX-4 Lx MCX4131A-GCAT 50GbE NIC | 1 | each |  |  | NVIDIA manual (https://networking-docs.nvidia.com/connectx4lxhw/specifications) |  | OWNED. ConnectX-4 Lx 50GbE single QSFP28, PCIe 3.0 x8. Sits in the Linkreal riser on an SFF-8643 port (all x16 slots hold V100s), so the link runs at Gen3 x4, about 25-28 Gb/s. Needs 300 LFM airflow; placement and QSFP28 DAC cable not chosen.
Linkreal LRFC6911N SFF-8643 to PCIe x16 (x4) adapter | 1 | each | $26.00 |  | Newegg (https://www.newegg.com/p/17Z-00TX-000C5) | https://lr-link.com/products/lrfc6911.html | SELECTED 2026-11-10, not ordered; ships from China. Takes an H12D-8D SFF-8643 port in PCIe mode and provides an x16 slot (Gen3 x4). SATA 15-pin power, 12 V and 3.3 V 5 A. No bracket: needs a printed holder and shelf position; board 121 x 114.1 mm per LR-Link; measure hole positions on arrival.
10Gtek CAB-8643/8643-P0.5M SFF-8643 cable, 0.5 m, sideband (2-pack) | 1 | 2-pack | $22.59 |  | Newegg (https://www.newegg.com/10Gtek-SCSI-SAS-InfiniBand-Cables/BrandSubCat/ID-137698-2835) | https://www.ebay.com/itm/405447883263 | SELECTED 2026-11-10, not ordered; price from a possibly stale listing. Straight male-to-male, 12G with sideband. One used, one spare.
Known total

Sheet: Kenshin
Item | Qty | Unit | Unit price (USD) | Total (USD) | Link | More links | Notes
AMD Ryzen 9 9950X3D | 1 | each
Gigabyte X870E AORUS PRO (ATX) | 1 | each
Corsair CMP64GX5M4B6400C32 DDR5 kit, 4 × 16 GB | 1 | each
Zotac Gaming GeForce RTX 5090 Solid 32 GB | 1 | each
Samsung 990 PRO 4 TB NVMe | 2 | each
Corsair HX1200i PSU | 1 | each
Lian Li GA II LITE Performance 360 (GA2L36PB) | 1 | each |  |  | specs (https://lian-li.com/product/ga-ii-lite/) |  | 360 mm AIO with three 120 mm fans; mounted at the shelf rear, exhausting rearward.
NVIDIA ConnectX-4 Lx MCX4131A-GCAT 50GbE NIC | 1 | each |  |  | NVIDIA manual (https://networking-docs.nvidia.com/connectx4lxhw/specifications) |  | OWNED. Goes in a chipset PCIEX4 slot (x4 electrical), so the link runs at Gen3 x4. Check that the RTX 5090 cooler leaves the slot usable. Needs 300 LFM airflow.
Known total
