cloudrift-ai/aipc/models/dual-pc-hammond-assembly.step

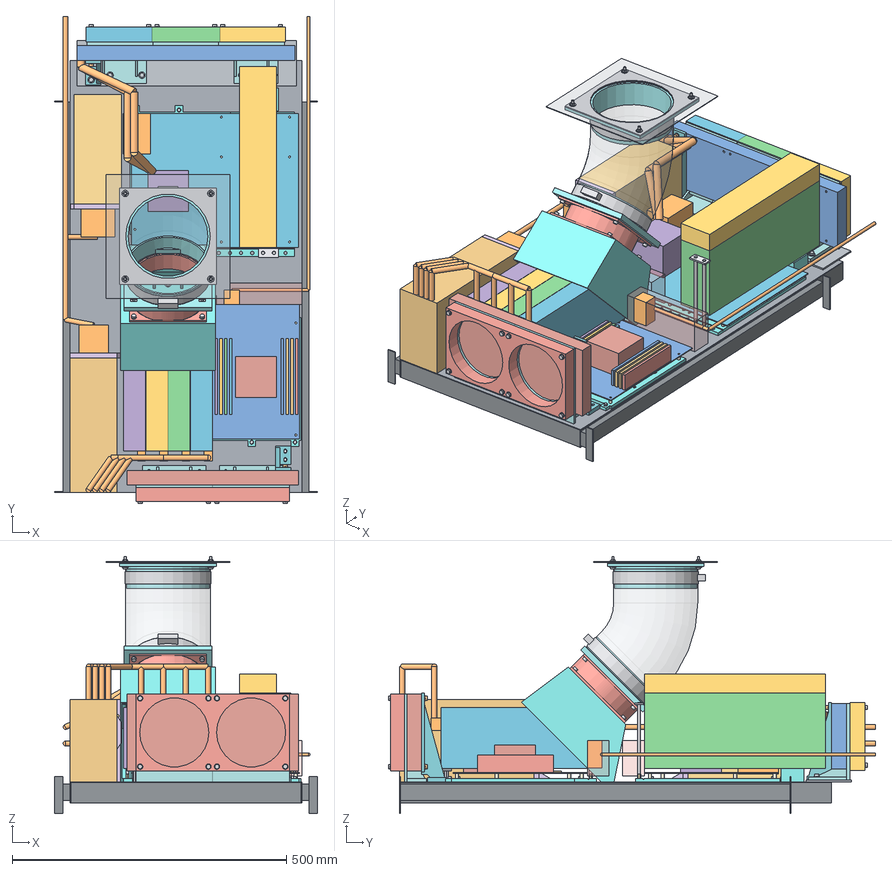
[picture p65: CAD file, 2026-11-13]
models/dual-pc-hammond-assembly.step
479.8 x 887.4 x 469.0 mm
Berserk_ATX_board
Berserk_V100_16GB_PCIE1
Berserk_V100_16GB_PCIE2
Berserk_V100_16GB_PCIE3
Berserk_V100_16GB_PCIE4
Berserk_SP3_CPU_and_pump_survey
Berserk_RDIMM_1_survey
Berserk_RDIMM_2_survey
Berserk_RDIMM_3_survey
Berserk_RDIMM_4_survey
Berserk_RDIMM_5_survey
Berserk_RDIMM_6_survey
Berserk_RDIMM_7_survey
Berserk_RDIMM_8_survey
Berserk_BMC_module_survey
V100_pressure_fan
Berserk_M2_SSD_1
Berserk_M2_SSD_2
Berserk_M2_SSD_3
Kenshin_ATX_board
Kenshin_RTX_5090
5090_straight_power-cable_keepout
Kenshin_GA_II_Lite_pump
Berserk_H115i_radiator
H115i_intake_fans
Berserk_owned_Hercules_1600W_PSU
Kenshin_owned_HX1200i_PSU
Kenshin_GA_II_Lite_radiator
Kenshin_AIO_exhaust_fan_1
Kenshin_AIO_exhaust_fan_2
Kenshin_AIO_exhaust_fan_3
V100_PCIE1_angled_EPS_plug_target
V100_PCIE2_angled_EPS_plug_target
V100_PCIE3_angled_EPS_plug_target
V100_PCIE4_angled_EPS_plug_target
Berserk_AC_plug_+_tail
Kenshin_low-profile_C13_plug_+_bend
Berserk_Ethernet_RJ45_boot_+_bend
Kenshin_24-pin_survey
V100_GPU_shroud
V100_inlet_M4_-62.25_-62.25
V100_inlet_M4_-62.25_62.25
V100_inlet_M4_62.25_-62.25
V100_inlet_M4_62.25_62.25
V100_hood_shelf_M4_123.53999999999999_375.0
V100_hood_shelf_M4_233.54_375.0
V100_hood_shelf_M4_178.54_380.5
PCIE1_metal_tail_support_survey
PCIE1_silicone_contact_pad_survey
PCIE2_metal_tail_support_survey
PCIE2_silicone_contact_pad_survey
PCIE3_metal_tail_support_survey
PCIE3_silicone_contact_pad_survey
PCIE4_metal_tail_support_survey
PCIE4_silicone_contact_pad_survey
Berserk_PCIE1_stock_backing_washer_1
Berserk_PCIE1_M3_SW5p5_14mm_standoff_1
Berserk_PCIE1_metal_OBT_PCIe_post_1_survey
Berserk_PCIE1_M3x8.0_and_washer_1_survey
Berserk_PCIE1_OBT_9mm_stud_1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
