cloudrift-ai/aipc/models/rear-aio-steel-extension-drill-plan.step

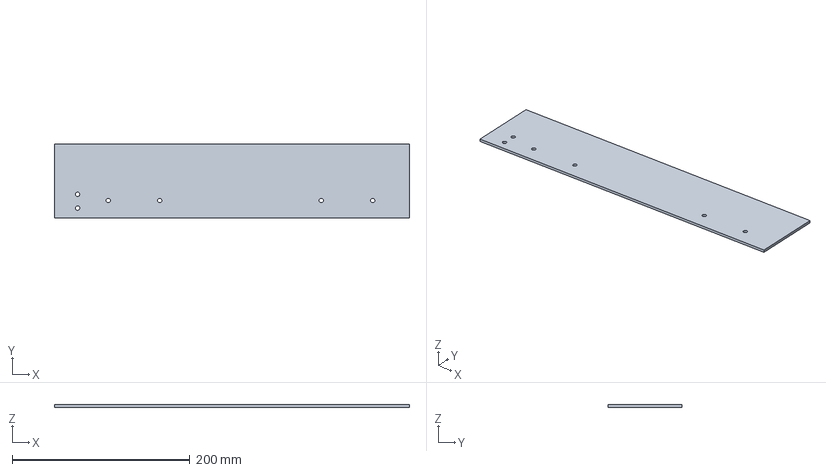
[picture p66: CAD file, 2026-11-13]
models/rear-aio-steel-extension-drill-plan.step
400.0 x 83.0 x 3.00 mm
