cloudrift-ai/aipc/parts/printed/atx_mobo_adapter_front/atx_mobo_adapter_front.step

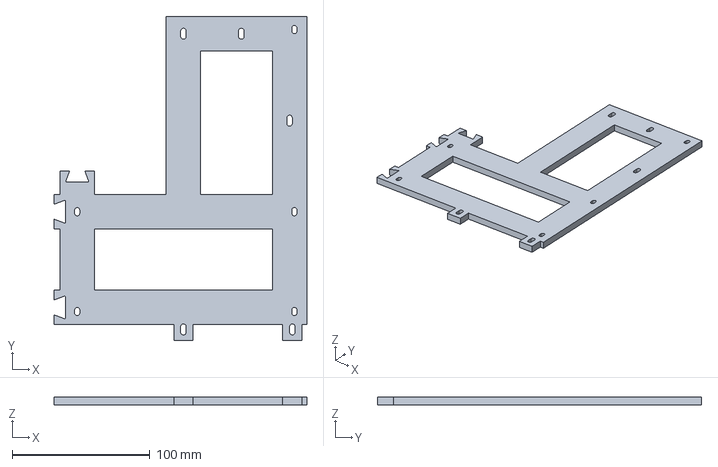
[picture p67: CAD file, 2026-11-13]
parts/printed/atx_mobo_adapter_front/atx_mobo_adapter_front.step
183.2 x 235.0 x 6.00 mm
