cloudrift-ai/aipc/parts/printed/atx_mobo_adapter_rail/atx_mobo_adapter_rail.step

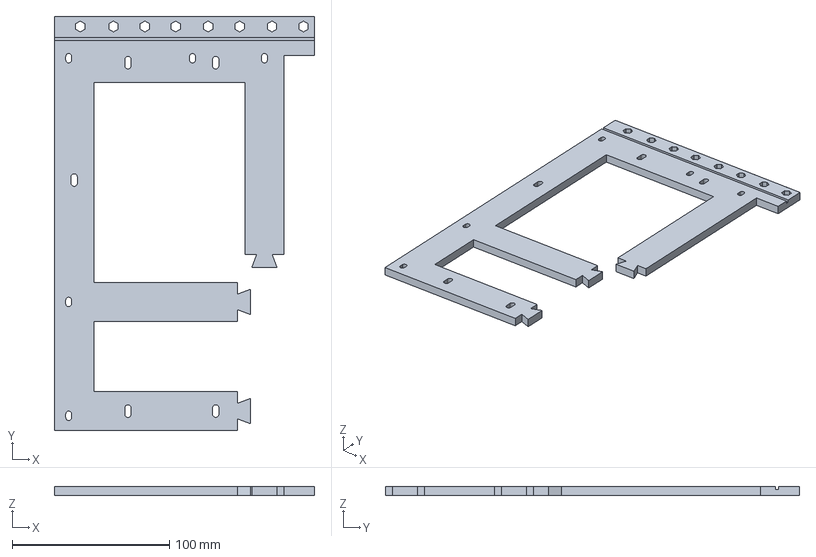
[picture p68: CAD file, 2026-11-13]
parts/printed/atx_mobo_adapter_rail/atx_mobo_adapter_rail.step
165.3 x 263.5 x 6.00 mm
