cloudrift-ai/aipc/parts/printed/fan120_aio_center_spacer/fan120_aio_center_spacer.step

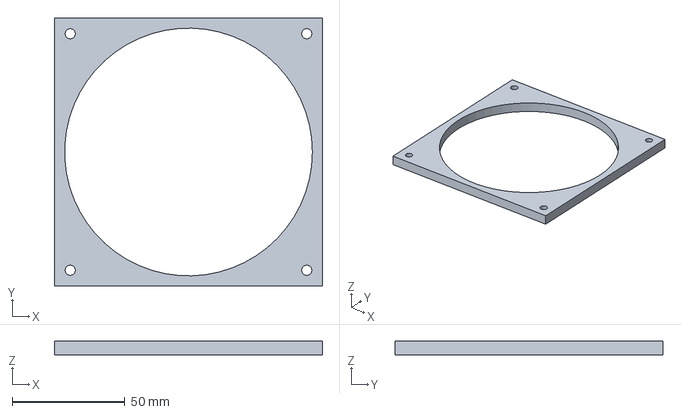
[picture p69: CAD file, 2026-11-13]
parts/printed/fan120_aio_center_spacer/fan120_aio_center_spacer.step
119.0 x 119.0 x 6.00 mm
