cloudrift-ai/aipc/parts/printed/fan120_aio_frame/fan120_aio_frame.step

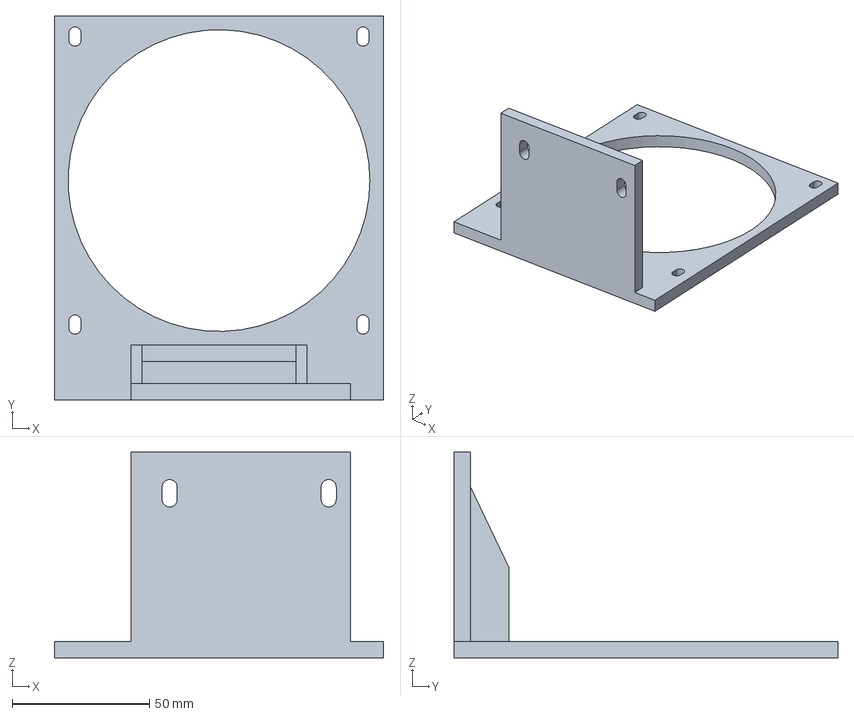
[picture p70: CAD file, 2026-11-13]
parts/printed/fan120_aio_frame/fan120_aio_frame.step
120.0 x 140.0 x 75.0 mm
