cloudrift-ai/aipc/parts/printed/fan120_aio_hose_brace/fan120_aio_hose_brace.step

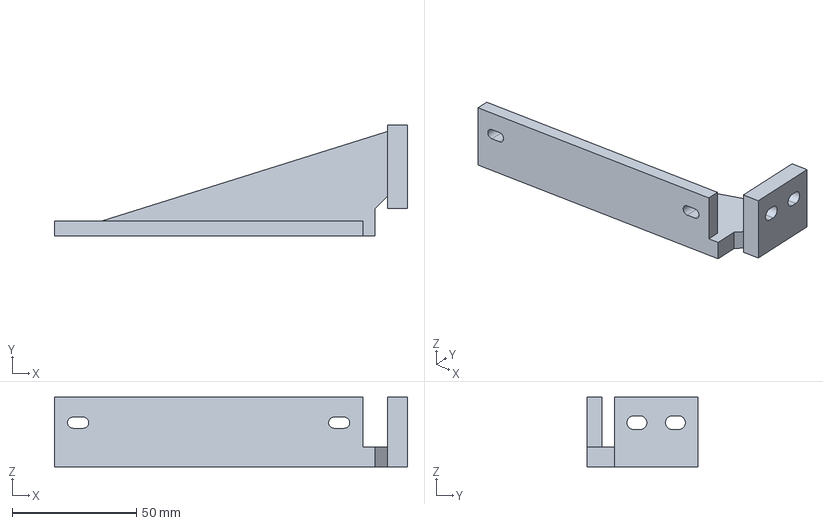
[picture p71: CAD file, 2026-11-13]
parts/printed/fan120_aio_hose_brace/fan120_aio_hose_brace.step
142.0 x 44.5 x 28.0 mm
