cloudrift-ai/aipc/parts/printed/fan140_aio_frame/fan140_aio_frame.step

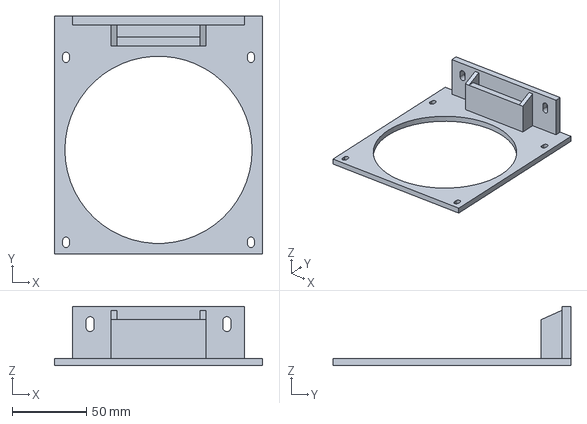
[picture p72: CAD file, 2026-11-13]
parts/printed/fan140_aio_frame/fan140_aio_frame.step
140.0 x 160.0 x 40.0 mm
