cloudrift-ai/aipc/parts/printed/fan140_aio_hose_brace/fan140_aio_hose_brace.step

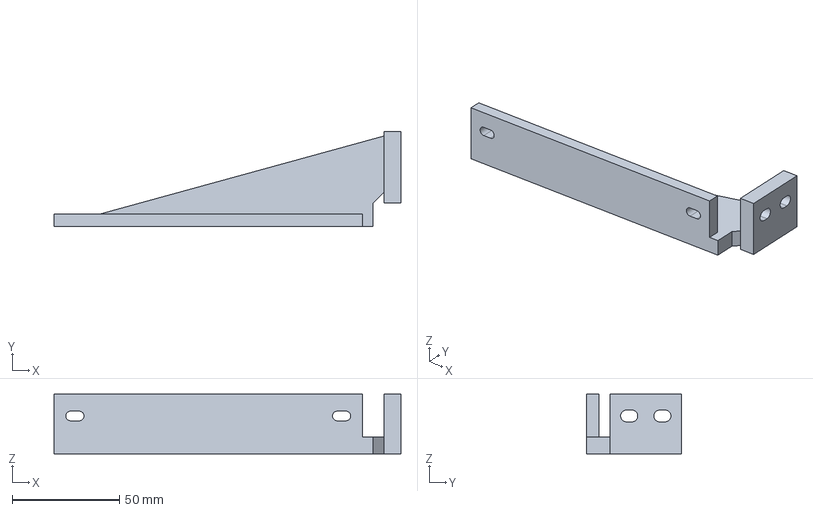
[picture p73: CAD file, 2026-11-13]
parts/printed/fan140_aio_hose_brace/fan140_aio_hose_brace.step
162.0 x 44.5 x 28.0 mm
