cloudrift-ai/aipc/parts/printed/gpu_exhaust_fan_flange/gpu_exhaust_fan_flange.step

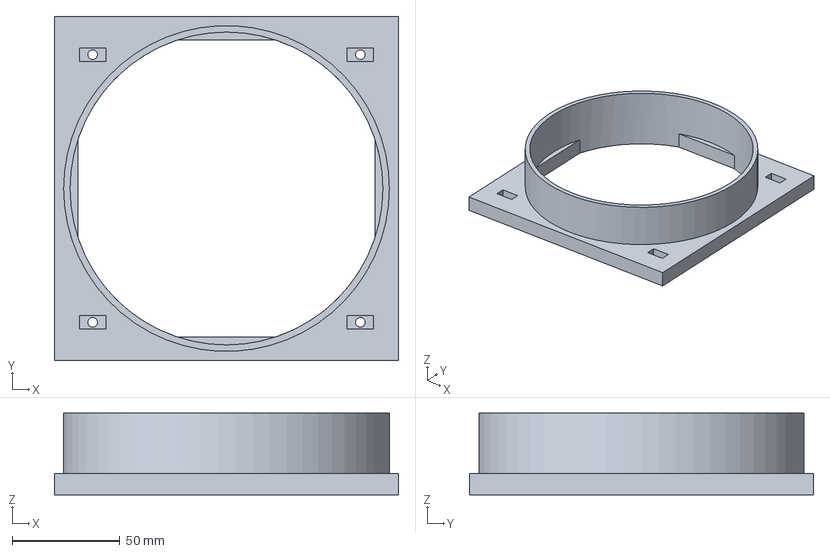
[picture p74: CAD file, 2026-11-13]
parts/printed/gpu_exhaust_fan_flange/gpu_exhaust_fan_flange.step
160.0 x 160.0 x 38.0 mm
