cloudrift-ai/aipc/parts/printed/gpu_exhaust_roof_flange/gpu_exhaust_roof_flange.step

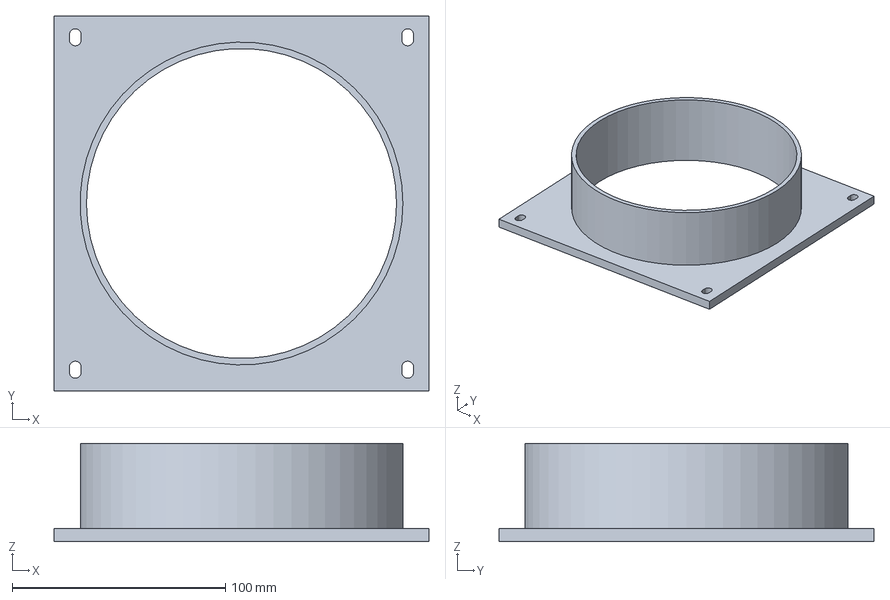
[picture p75: CAD file, 2026-11-13]
parts/printed/gpu_exhaust_roof_flange/gpu_exhaust_roof_flange.step
176.0 x 176.0 x 46.0 mm
