cloudrift-ai/aipc/parts/printed/gpu_rest/gpu_rest.step

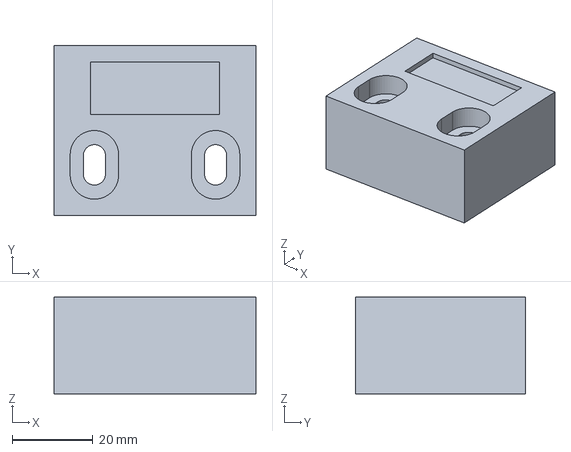
[picture p76: CAD file, 2026-11-13]
parts/printed/gpu_rest/gpu_rest.step
50.0 x 42.0 x 24.0 mm
