cloudrift-ai/aipc/parts/printed/psu_bracket/psu_bracket.step

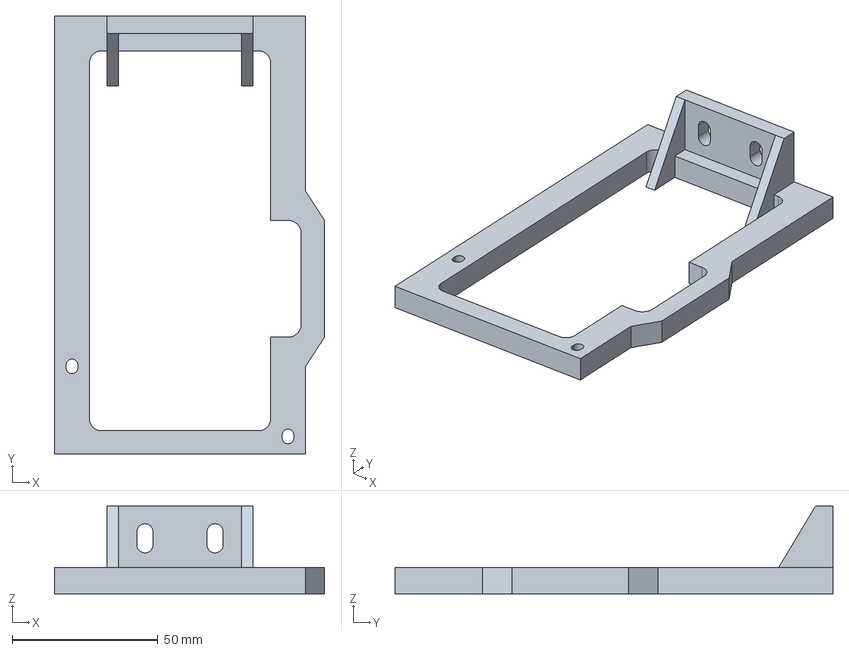
[picture p77: CAD file, 2026-11-13]
parts/printed/psu_bracket/psu_bracket.step
92.5 x 150.0 x 30.0 mm
