cloudrift-ai/aipc/parts/printed/tnut_fit_coupon/tnut_fit_coupon.step

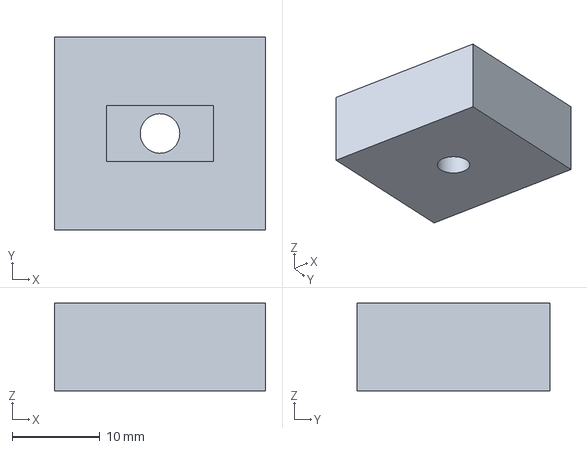
[picture p78: CAD file, 2026-11-13]
parts/printed/tnut_fit_coupon/tnut_fit_coupon.step
24.0 x 22.0 x 10.0 mm
