cloudrift-ai/aipc/parts/printed/v100_gpu_shroud/v100_gpu_shroud.step

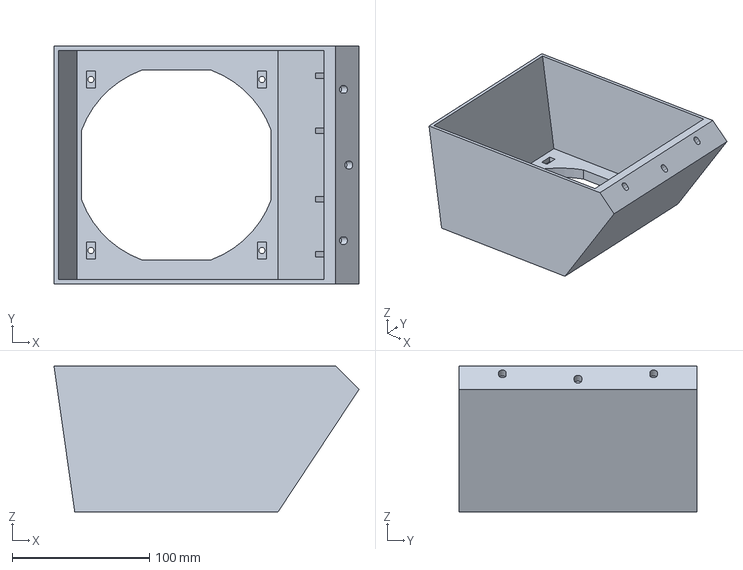
[picture p79: CAD file, 2026-11-13]
parts/printed/v100_gpu_shroud/v100_gpu_shroud.step
222.0 x 173.3 x 106.2 mm
