cloudrift-ai/aipc/models/v100-tilted-exhaust.step

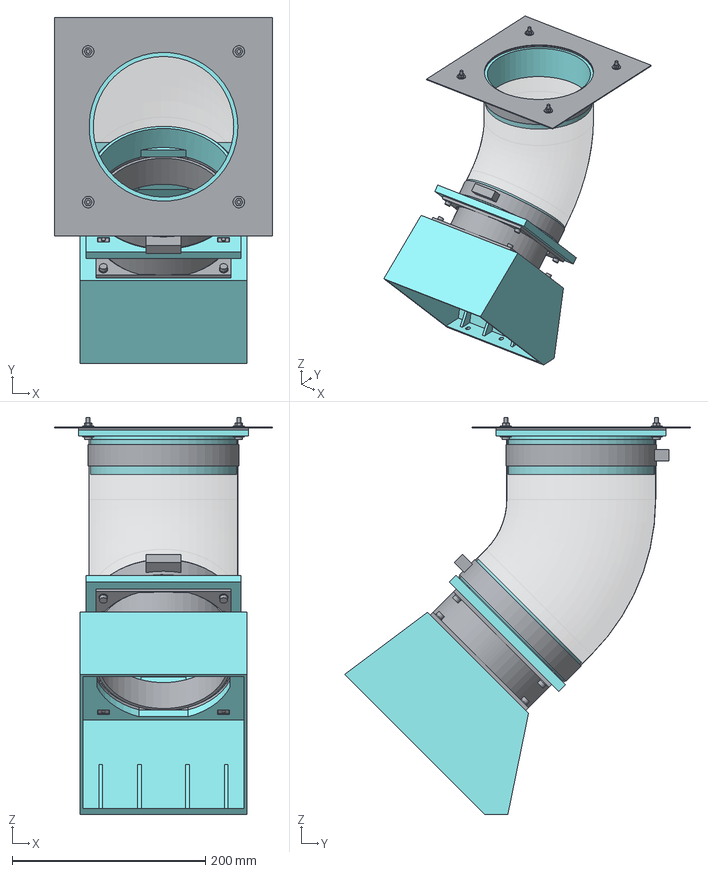
[picture p80: CAD file, 2026-11-13]
models/v100-tilted-exhaust.step
226.0 x 357.9 x 411.0 mm
gpu_exhaust_fan_flange
gpu_exhaust_roof_flange
flex_duct_6in_ADJUSTABLE_ROUTE
53185K52_fan_clamp_envelope
53185K52_roof_clamp_envelope
inner_ceiling_patch_PROVISIONAL
roof_silicone_gasket
fan_outlet_M4_-62.25_-62.25
fan_outlet_M4_-62.25_62.25
fan_outlet_M4_62.25_-62.25
fan_outlet_M4_62.25_62.25
roof_M4_-78.0_-78.0
roof_M4_-78.0_78.0
roof_M4_78.0_-78.0
roof_M4_78.0_78.0
inlet_M4_-62.25_-62.25
inlet_M4_-62.25_62.25
inlet_M4_62.25_-62.25
inlet_M4_62.25_62.25
fan
shroud
