cloudrift-ai/aipc/models/rsus1931bk1-drill-plan-deck.step

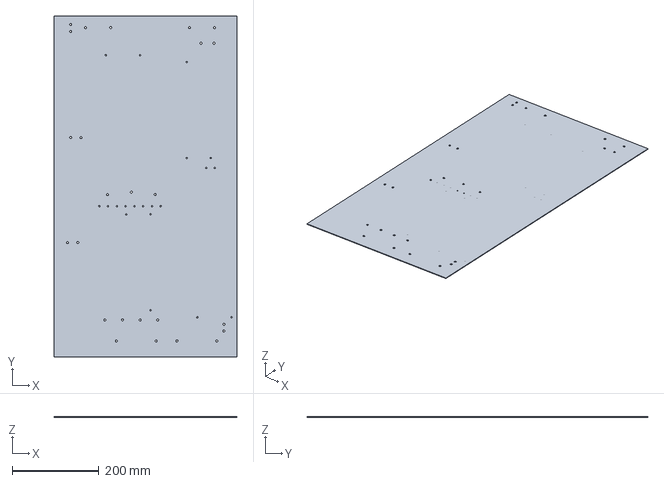
[picture p81: CAD file, 2026-11-13]
models/rsus1931bk1-drill-plan-deck.step
422.7 x 787.4 x 1.52 mm
