cloudrift-ai/aipc/models/adjshelfhdv-approx-vented-deck.stl

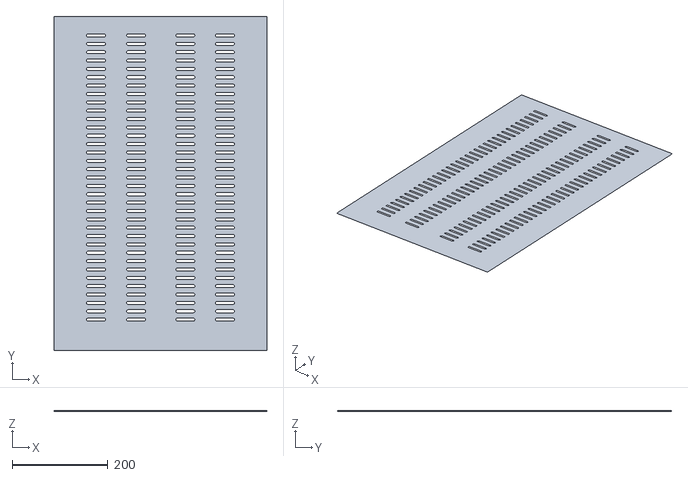
[picture p82: CAD file, 2026-10-21]
models/adjshelfhdv-approx-vented-deck.stl
446.0 x 700.0 x 1.20
