cloudrift-ai/aipc/print/05_psu_brackets.3mf

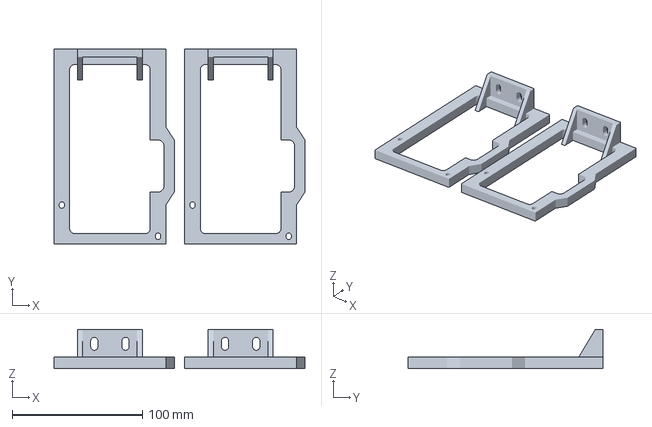
[picture p83: CAD file, 2026-10-24]
print/05_psu_brackets.3mf
193.0 x 150.0 x 30.0 mm
psu_bracket x 2
