cloudrift-ai/aipc/(list of files, cad)

Other CAD files:
parts/fabricated/rear-aio-steel-extension/rear-aio-steel-extension.step
parts/printed/h12d_mobo_adapter_rail/h12d_mobo_adapter_rail.step
print/03_h12d_mobo_adapter_rail.3mf
print/02_atx_mobo_adapter_rail.3mf
print/09_fan120_aio_hose_brace.3mf
print/04_gpu_rest.3mf
models/rsus1931bk1-solid-deck.step
print/08_fan120_aio_frame.3mf
print/01_atx_mobo_adapter_front.3mf
print/12_v100_gpu_shroud.3mf
models/adjshelfhdv-drill-plan-deck.stl
print/13_gpu_exhaust_fan_flange.3mf
print/06_fan140_aio_frame.3mf
print/14_gpu_exhaust_roof_flange.3mf
print/11_tnut_fit_coupon.3mf
print/10_fan120_aio_center_spacer.3mf
print/07_fan140_aio_hose_brace.3mf
models/pcie-post-backing-washer-reference.step
parts/printed/atx_mobo_adapter_front/atx_mobo_adapter_front.stl
parts/printed/atx_mobo_adapter_rail/atx_mobo_adapter_rail.stl
parts/printed/fan120_aio_center_spacer/fan120_aio_center_spacer.stl
parts/printed/fan120_aio_frame/fan120_aio_frame.stl
parts/printed/fan120_aio_hose_brace/fan120_aio_hose_brace.stl
parts/printed/fan140_aio_frame/fan140_aio_frame.stl
parts/printed/fan140_aio_hose_brace/fan140_aio_hose_brace.stl
parts/printed/gpu_exhaust_fan_flange/gpu_exhaust_fan_flange.stl
parts/printed/gpu_exhaust_roof_flange/gpu_exhaust_roof_flange.stl
parts/printed/gpu_rest/gpu_rest.stl
parts/printed/h12d_mobo_adapter_rail/h12d_mobo_adapter_rail.stl
parts/printed/psu_bracket/psu_bracket.stl
parts/printed/tnut_fit_coupon/tnut_fit_coupon.stl
parts/printed/v100_gpu_shroud/v100_gpu_shroud.stl
parts/purchased/ac-power-cords/ac-power-cords.step
parts/purchased/amd-epyc-7702p/amd-epyc-7702p.step
parts/purchased/corsair-h115i/corsair-h115i.step
parts/purchased/corsair-hx1200i/corsair-hx1200i.step
parts/purchased/fasteners/fasteners.step
parts/purchased/flex-duct-6in/flex-duct-6in.step
parts/purchased/gigabyte-x870e-aorus-pro/gigabyte-x870e-aorus-pro.step
parts/purchased/hammond-rsus1931bk1/hammond-rsus1931bk1.step
parts/purchased/huananzhi-h12d-8d/huananzhi-h12d-8d.step
parts/purchased/keystone-1451b/keystone-1451b.step
parts/purchased/lian-li-ga2-lite-360/lian-li-ga2-lite-360.step
parts/purchased/mcmaster-53185k52/mcmaster-53185k52.step
parts/purchased/micron-3400-2tb/micron-3400-2tb.step
parts/purchased/micron-3500-2tb/micron-3500-2tb.step
parts/purchased/micron-mta36asf4g72pz-2g9/micron-mta36asf4g72pz-2g9.step
parts/purchased/moddiy-eps-90-extension/moddiy-eps-90-extension.step
parts/purchased/nvidia-v100-pcie-16gb/nvidia-v100-pcie-16gb.step
parts/purchased/obt-pcie-support/obt-pcie-support.step
parts/purchased/rack-cabinet/rack-cabinet.step
parts/purchased/rosewill-hercules-1600/rosewill-hercules-1600.step
parts/purchased/sanyo-denki-9gv1412p1s001/sanyo-denki-9gv1412p1s001.step
parts/purchased/silicone-gasket-2mm/silicone-gasket-2mm.step
parts/purchased/v100-eps-power-adapter/v100-eps-power-adapter.step
parts/purchased/v100-tail-support/v100-tail-support.step
parts/purchased/wurth-970140324/wurth-970140324.step
parts/purchased/zotac-rtx-5090-solid/zotac-rtx-5090-solid.step
