cloudrift-ai/aipc/parts/fabricated/fan-power-harness/README.md

# Fused PWM pass-through harness for the pressure fan

<!-- Generated by make check from part.toml. Edit part.toml, not this file. -->

| | |
| --- | --- |
| ID | `fan-power-harness` |
| Category | fabricated |
| Role | feeds the San Ace motor from the PSU and passes PWM/tach to the QUADRO |
| Status | design |
| Quantity | 1 |
| Systems | berserk |

PSU 4-pin peripheral (Molex) 12 V and ground -> 5 A inline blade fuse -> fan
pins 2 (+12 V, red) and 1 (ground, black). Fan pin 3 (tach, yellow) and pin 4
(PWM, brown) -> QUADRO channel pins 3 and 4. QUADRO channel pin 1 (ground)
joins the fan ground for a common reference; QUADRO pin 2 (+12 V) stays
unconnected. Use 18 AWG for the 12 V pair. Confirm the San Ace starting
current (catalog p.616) is within the fuse's slow-blow curve.

## Model

- Source: constructed
- Assembly: **not in the assembly**: flexible wiring; route along the hood clear of the fan rotor

## Datasheets

- None recorded. 

## Dimensions

| Key | Value | Evidence | Source / note |
| --- | --- | --- | --- |
| fuse_rating | 5 A | allowance | 3.1 A rated fan current plus start-up margin |
| mass | 0.05 kg | assumed |  |

## Interfaces

- provides `fan-power` value 12 V PWM 4-wire, 3.1 A count 1 (allowance)
- requires `fan-pwm-control` value 25 kHz PWM + tach, Linux hwmon count 1 (allowance)
- requires `peripheral-12v` count 1 (allowance)

## Compatibility checks

| Status | Rule | Interface | Detail |
| --- | --- | --- | --- |
| provisional | value | `fan-power` | sanyo-denki-9gv1412p1s001 needs 12 V PWM 4-wire, 3.1 A; provided by fan-power-harness |
| provisional | count | `fan-power` | need 1 x fan-power=12 v pwm 4-wire, 3.1 a, have 1 |
| provisional | value | `fan-pwm-control` | fan-power-harness needs 25 kHz PWM + tach, Linux hwmon; provided by aquacomputer-quadro |
| provisional | count | `fan-pwm-control` | need 1 x fan-pwm-control=25 khz pwm + tach, linux hwmon, have 4 |
| provisional | count | `peripheral-12v` | need 1 x peripheral-12v, have 2 |
| provisional | budget | `shelf-load` | load 23.7 kg of 39.0 kg x derate 1.0 = 39.0 kg (61% of rating) |
