cloudrift-ai/aipc/parts/printed/fan120_aio_center_spacer/README.md

# fan120_aio_center_spacer

<!-- Generated by make check from part.toml. Edit part.toml, not this file. -->

| | |
| --- | --- |
| ID | `fan120_aio_center_spacer` |
| Category | printed |
| Role | keeps the middle 120 mm fan coplanar |
| Status | design |
| Quantity | 1 |
| Systems | kenshin |
| Print | plate `10_fan120_aio_center_spacer`, PETG |

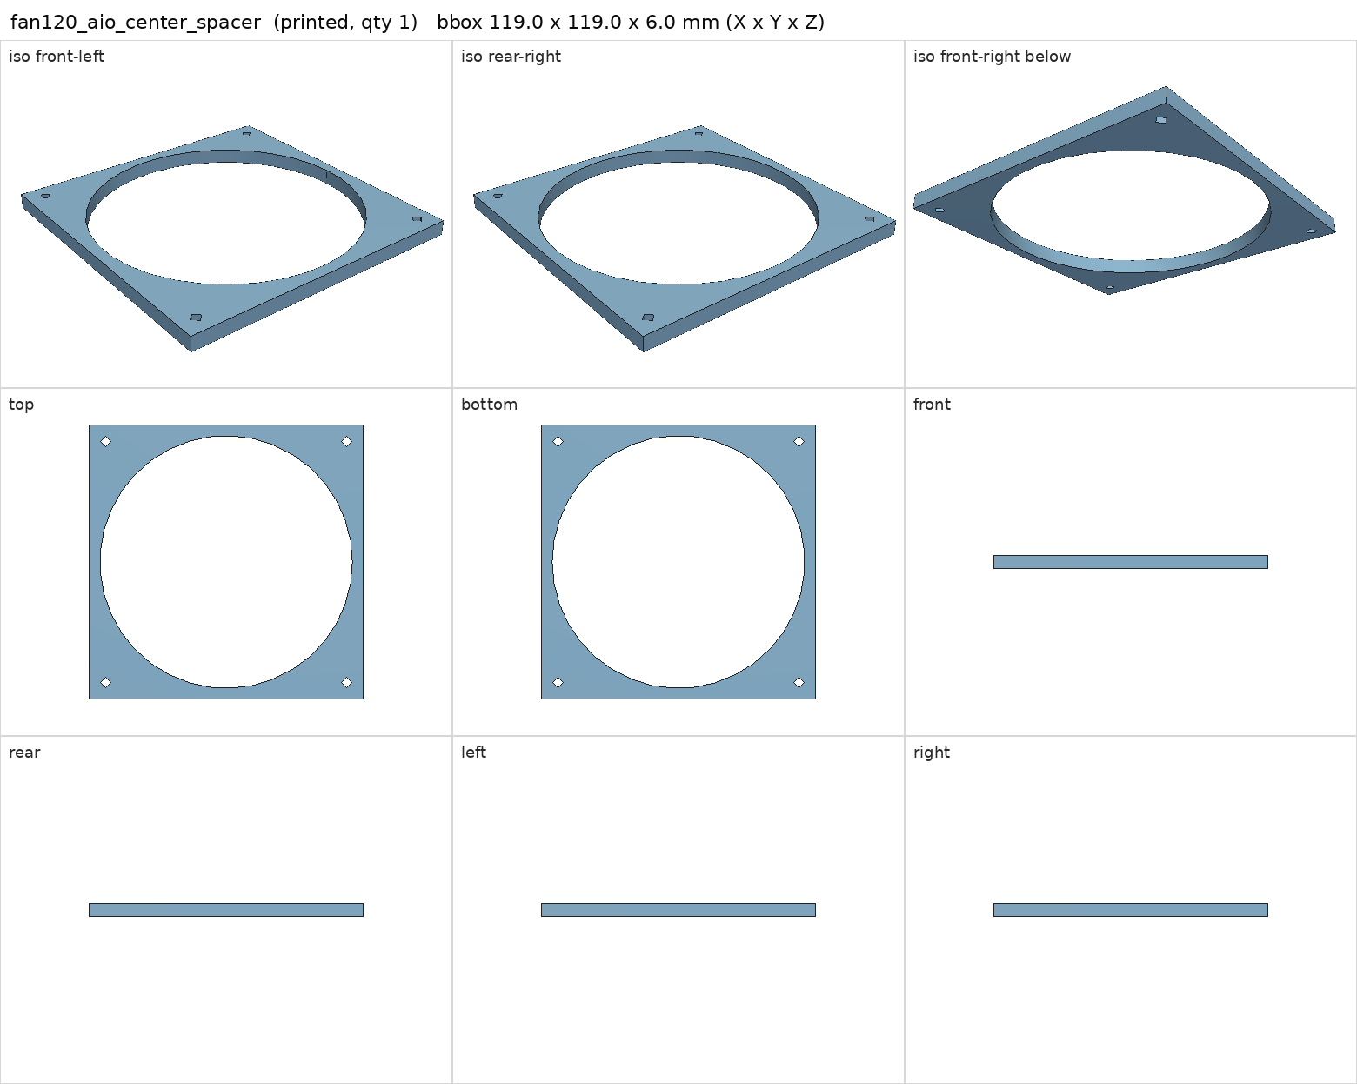
[picture p90: parts/printed/fan120_aio_center_spacer/render.png]
Part views


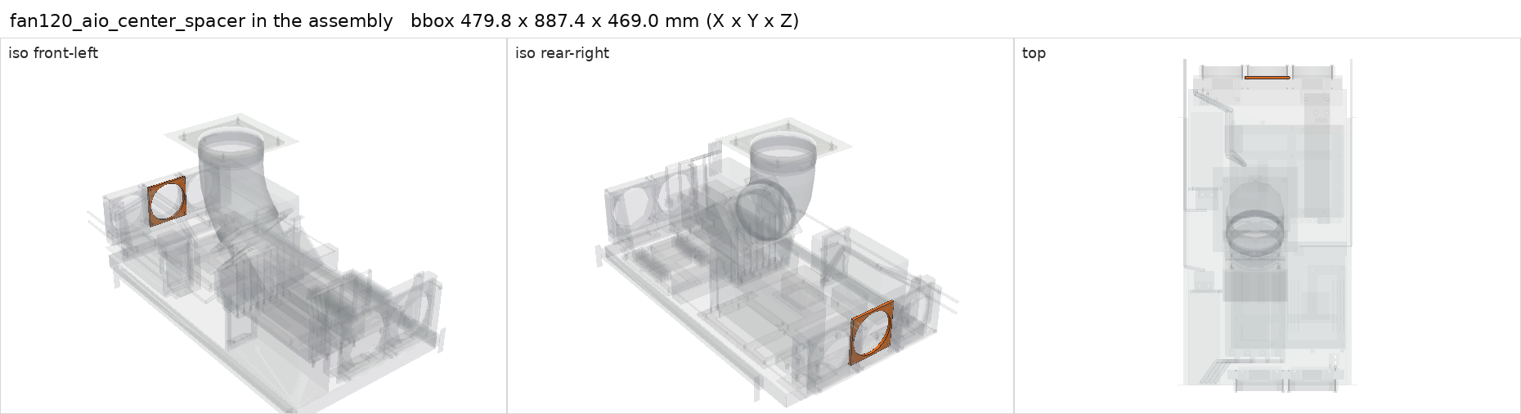
[picture p91: parts/printed/fan120_aio_center_spacer/in-assembly.png]
Part in the assembly


## Model

- [fan120_aio_center_spacer.step](fan120_aio_center_spacer.step) and [fan120_aio_center_spacer.stl](fan120_aio_center_spacer.stl)
- Source: generated. Exported by cad/shelf_layout.py in shelf coordinates; print/ re-orients it on the plate.
- Assembly: 1 instances in the assembly

## Datasheets

- None recorded. 

## Dimensions

| Key | Value | Evidence | Source / note |
| --- | --- | --- | --- |
| mass | 0.0249 kg | allowance | OrcaSlicer filament estimate |

## Compatibility checks

| Status | Rule | Interface | Detail |
| --- | --- | --- | --- |
| provisional | budget | `shelf-load` | load 23.7 kg of 39.0 kg x derate 1.0 = 39.0 kg (61% of rating) |
