cloudrift-ai/aipc/parts/printed/fan140_aio_hose_brace/README.md

# fan140_aio_hose_brace

<!-- Generated by make check from part.toml. Edit part.toml, not this file. -->

| | |
| --- | --- |
| ID | `fan140_aio_hose_brace` |
| Category | printed |
| Role | hose-end brace for the 140 mm radiator |
| Status | design |
| Quantity | 1 |
| Systems | berserk |
| Print | plate `07_fan140_aio_hose_brace`, PETG |

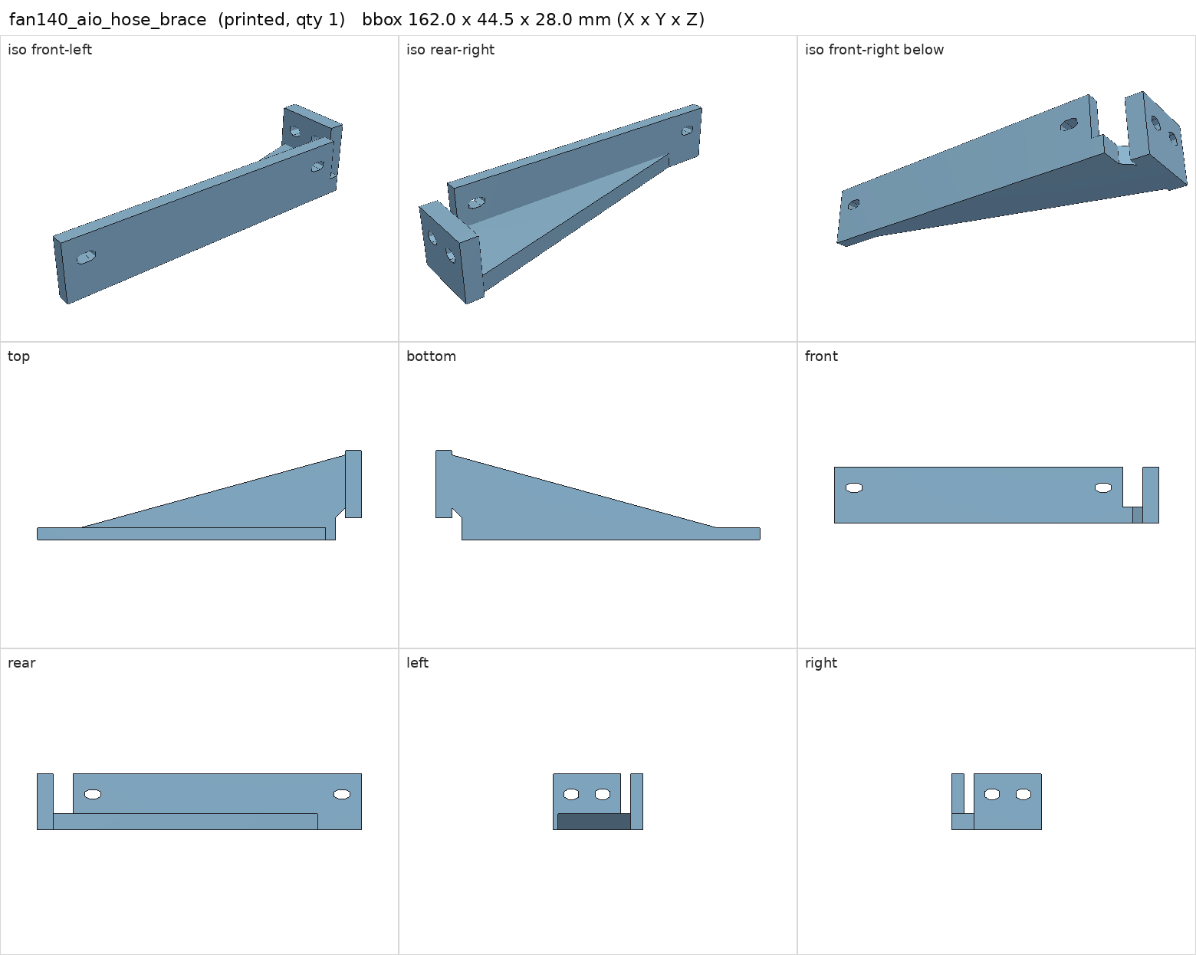
[picture p98: parts/printed/fan140_aio_hose_brace/render.png]
Part views


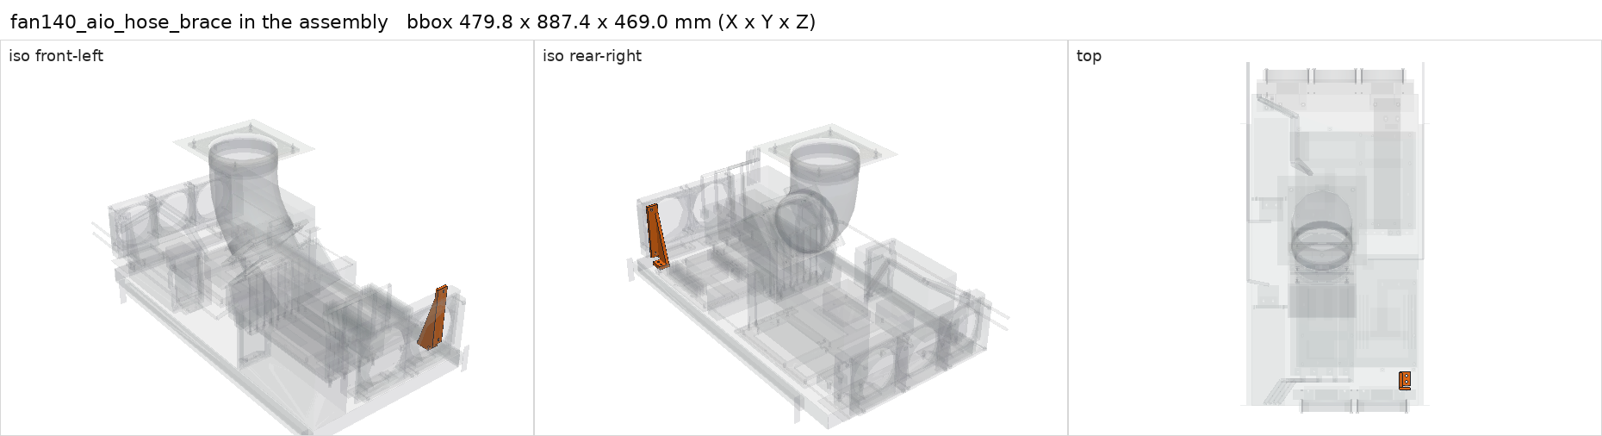
[picture p99: parts/printed/fan140_aio_hose_brace/in-assembly.png]
Part in the assembly


## Model

- [fan140_aio_hose_brace.step](fan140_aio_hose_brace.step) and [fan140_aio_hose_brace.stl](fan140_aio_hose_brace.stl)
- Source: generated. Exported by cad/shelf_layout.py in shelf coordinates; print/ re-orients it on the plate.
- Assembly: 1 instances in the assembly

## Datasheets

- None recorded. 

## Dimensions

| Key | Value | Evidence | Source / note |
| --- | --- | --- | --- |
| mass | 0.0415 kg | allowance | OrcaSlicer filament estimate |

## Compatibility checks

| Status | Rule | Interface | Detail |
| --- | --- | --- | --- |
| provisional | budget | `shelf-load` | load 23.7 kg of 39.0 kg x derate 1.0 = 39.0 kg (61% of rating) |
