cloudrift-ai/aipc/models/assembly-details.png

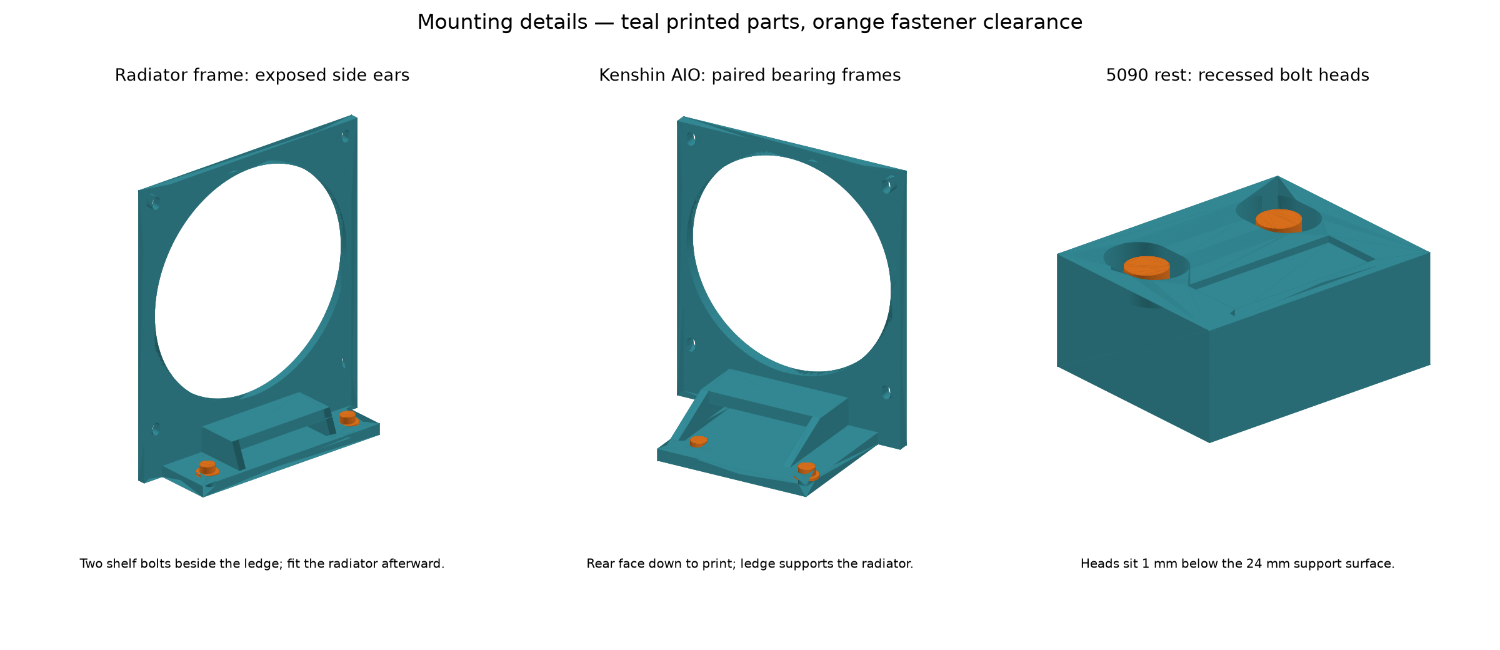
models/assembly-details.png
