cloudrift-ai/aipc/models/atx_mobo_adapter_rail-print-review.png

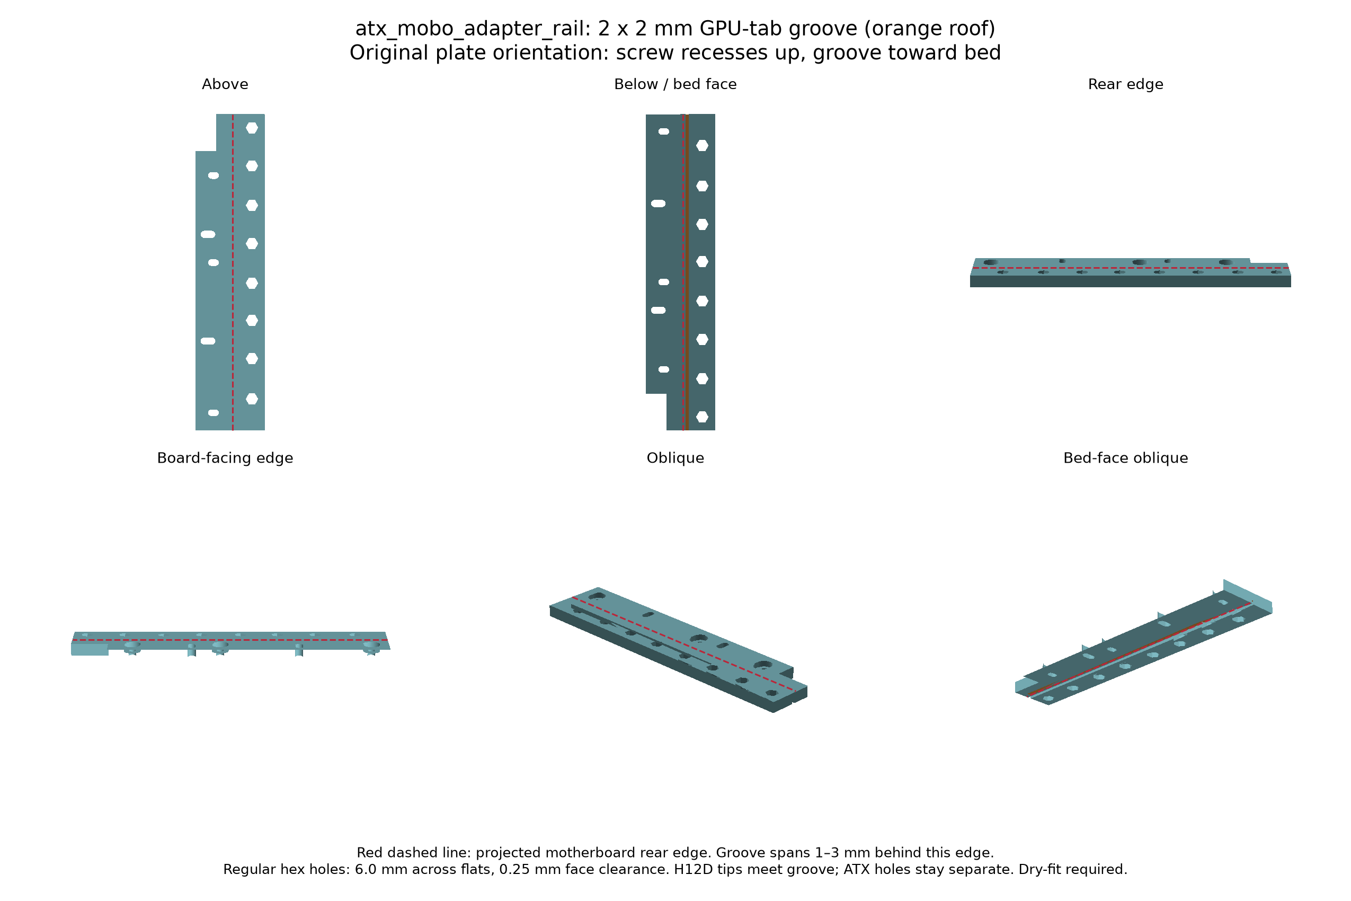
models/atx_mobo_adapter_rail-print-review.png
