cloudrift-ai/aipc/models/renders/assembly-kenshin.png

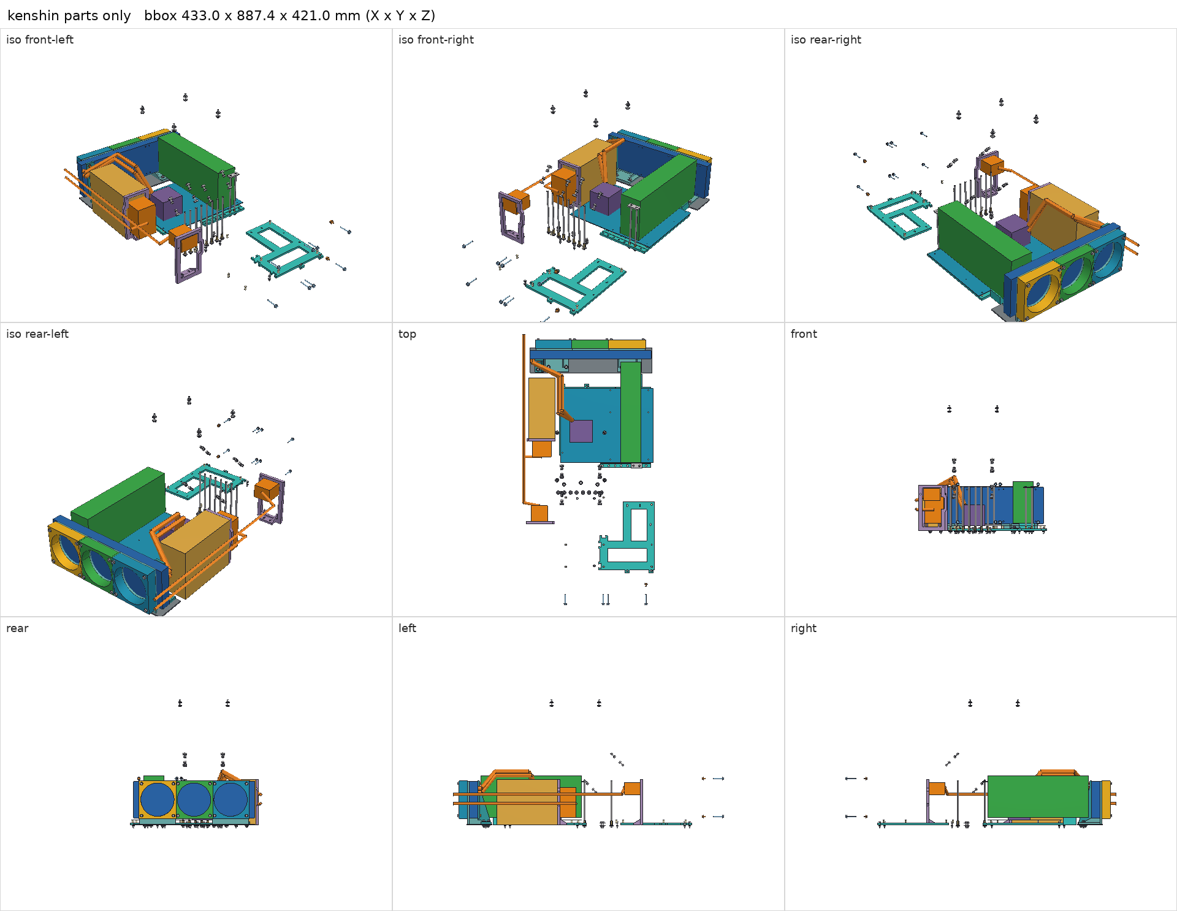
models/renders/assembly-kenshin.png
