cloudrift-ai/aipc/models/renders/assembly-shelf.png

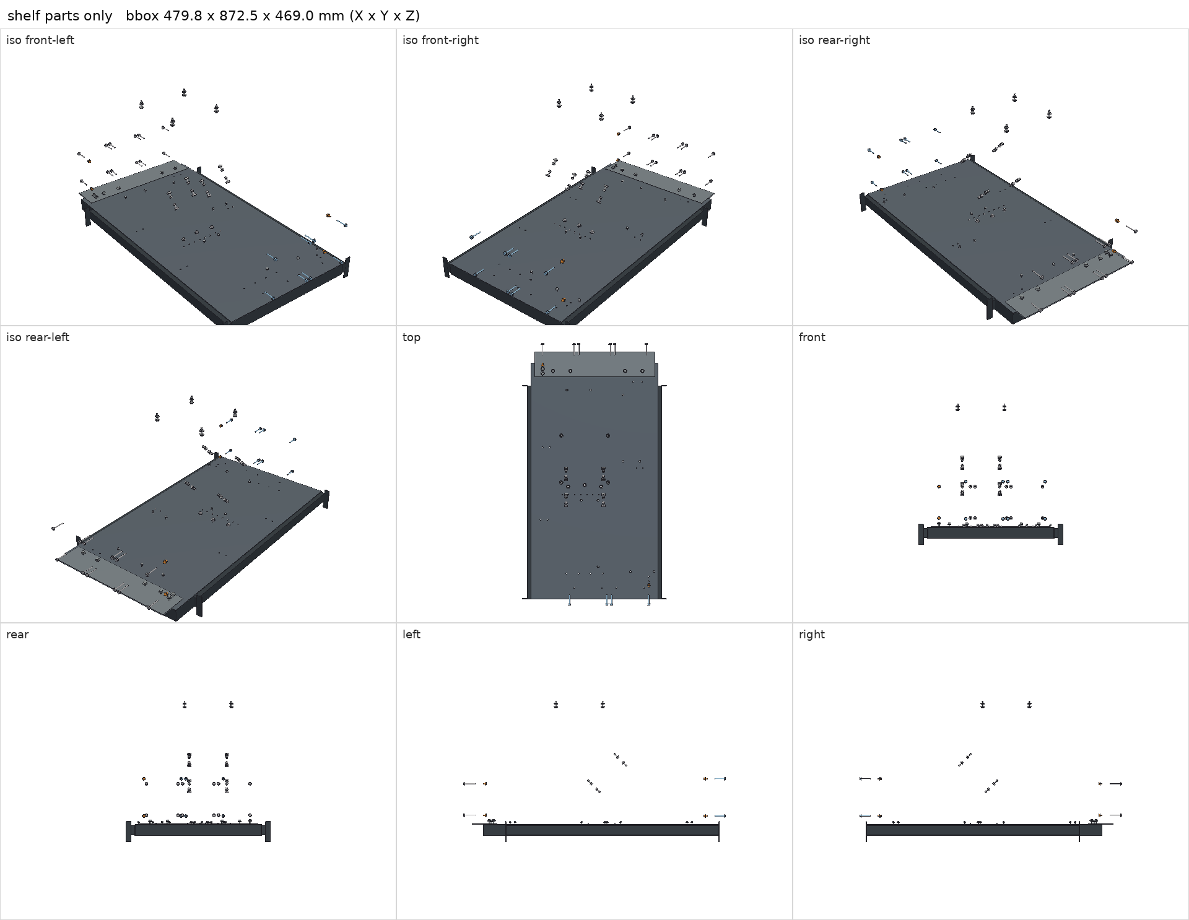
models/renders/assembly-shelf.png
