cloudrift-ai/aipc/(commit log)

2026-10-21 Extract open-shelf dual-PC build from construction repo
    One model per unique printed part: shared ATX front section, ATX and
    H12D rail sections, a single PSU bracket for both PSUs, and one each of
    the 120/140 mm AIO frames and braces. Plates carry print counts; G-code
    is gitignored and generated with make gcode. Parts list trimmed to the
    shelf hardware plus Berserk and Kenshin components.
    [01_atx_mobo_adapter_front.3mf, 02_atx_mobo_adapter_rail.3mf, 03_h12d_mobo_adapter_rail.3mf, 04_gpu_rest.3mf, 05_psu_brackets.3mf, 06_fan140_aio_frame.3mf, 07_fan140_aio_hose_brace.3mf, 08_fan120_aio_frame.3mf]
2026-10-21 Move parts list to a tabbed spreadsheet and add MIT license
    [parts.xlsx]
2026-10-22 Select three 2TB PC801 SSDs for Berserk RAID 0
    [parts.xlsx]
2026-10-24 Add GPU bracket clearance grooves at the motherboard rear edge
    Use the ATX and PCIe nominal bracket datum to place 2 mm wide, 2 mm deep grooves 1–3 mm behind the PCB edge. Preserve washer seats and the original support-free print orientation.
    Regenerate CAD, print plates and previews. Document standards references, physical fit limits, and the independent geometry and sliced-layer audit; all 14 Orca slices passed.
    [01_atx_mobo_adapter_front.3mf, 02_atx_mobo_adapter_rail.3mf, 03_h12d_mobo_adapter_rail.3mf, 04_gpu_rest.3mf, 05_psu_brackets.3mf, 06_fan140_aio_frame.3mf, 07_fan140_aio_hose_brace.3mf, 08_fan120_aio_frame.3mf]
2026-10-24 Mount GPU posts through snug hex holes directly to steel
    Use 14 mm M3 through-thread bases and M3x6 underside screws to clear the owner-reported 9 mm OBT studs. Locate the bases with regular 5.8 mm hex openings and retain each adapter with five independent shelf anchors.
    Regenerate CAD, print plates, previews and fit reports; update assembly guidance and the parts workbook. CAD checks, all 14 support-free slices and the independent prototype print audit passed. Actual hardware fit remains provisional.
    [02_atx_mobo_adapter_rail.3mf, 03_h12d_mobo_adapter_rail.3mf, adjshelfhdv-approx-vented-deck.step, adjshelfhdv-drill-plan-deck.step, atx_mobo_adapter_front.step, atx_mobo_adapter_rail.step, atx_mobo_adapter_rail.stl, fan120_aio_center_spacer.step]
2026-11-05 Add centered rack rails and tapered shelf shim trials
    [15_rail_shelf_shim_trials.3mf, kenshin-berserk-6u-shelf-envelope.step, rail_shelf_shim_1mm.step, rail_shelf_shim_1mm.stl, rail_shelf_shim_2mm.step, rail_shelf_shim_2mm.stl, rail_shelf_shim_3mm.step, rail_shelf_shim_3mm.stl]
2026-11-05 Update Berserk memory and storage selections
    [parts.xlsx]
2026-11-05 Print four of each shelf shim on one plate
    [15_rail_shelf_shim_trials.3mf]
2026-11-06 Rework dual-PC layout for Hammond sliding shelf
    Use RSUS1931BK1 with factory slides, rotate the rear system for service clearance, and add a steel rear radiator extension with revised printed mounts. Update the assembly, drill plans, parts workbook, documentation and 14 print plates; retire the King Slide shim adaptation.
    Validation: full CAD and plate regeneration, all 14 support-free OrcaSlicer jobs, and independent assembly and changed-part print review passed. Physical fit, load and thermal checks remain provisional.
    [01_atx_mobo_adapter_front.3mf, 03_h12d_mobo_adapter_rail.3mf, 04_gpu_rest.3mf, 08_fan120_aio_frame.3mf, 09_fan120_aio_hose_brace.3mf, 12_v100_gpu_shroud.3mf, 15_rail_shelf_shim_trials.3mf, adjshelfhdv-approx-vented-deck.step]
2026-11-07 Formalize per-part folders, renders, assembly coverage and compatibility checks
    - parts/<category>/<id>/: part.toml with evidence-tagged dimensions and
    interfaces, generated README, assembly model, render.png, in-assembly.png;
    datasheets fetched by make datasheets (gitignored).
    - cad/aipc shared library: spec lookup, export, assembly registry, headless
    VTK rendering, provides/requires compatibility engine, part docs.
    - Generators read component dimensions from the specs; printed STEP/STL move
    into their part folders; printed geometry unchanged.
    - make cad fails unless every assembly instance maps to a part and every part
    is modeled, covered or explicitly not modeled. Berserk M.2 SS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
    [01_atx_mobo_adapter_front.3mf, 02_atx_mobo_adapter_rail.3mf, 03_h12d_mobo_adapter_rail.3mf, 04_gpu_rest.3mf, 05_psu_brackets.3mf, 06_fan140_aio_frame.3mf, 07_fan140_aio_hose_brace.3mf, 08_fan120_aio_frame.3mf]
2026-11-07 Mount the H115i on SP3 with an Asetek TR4/SP3 bracket
    Owner accepted partial cold-plate coverage on 2026-11-06. New part
    asetek-tr4-bracket provides the SP3 cooler mount; the H115i provides the
    round-pump interface. The cooler-mount FAIL becomes provisional until the
    bracket is sourced.
    [ac-power-cords.step, amd-epyc-7702p.step, atx_mobo_adapter_front.step, atx_mobo_adapter_rail.step, corsair-h115i.step, corsair-hx1200i.step, dual-pc-hammond-assembly.step, fan120_aio_center_spacer.step]
2026-11-07 Choose an Aquacomputer QUADRO for the V100 pressure fan
    The QUADRO supplies PWM and tach only (25 W per channel is below the San Ace's
    37.2 W); a fused Molex harness feeds the motor from the PSU. The Linux
    aquacomputer_d5next driver exposes writable pwm, so a host service can drive
    the fan from the hottest GPU. Replaces the unspecified fan-controller part;
    the H12D internal USB 2.0 header is now an open check.
    [ac-power-cords.step, amd-epyc-7702p.step, atx_mobo_adapter_front.step, atx_mobo_adapter_rail.step, corsair-h115i.step, corsair-hx1200i.step, dual-pc-hammond-assembly.step, fan120_aio_center_spacer.step]
2026-11-08 Record Berserk's installed hardware after first boot
    The board, CPU, memory and SSDs are now owned and installed, with what the
    running system reported on 2026-11-07. The eBay order for three Micron
    3400s delivered two 3400s and one 3500, so the 3500 gets its own part and
    the M.2 slots in the shelf layout read each installed drive's spec. The
    drives' measured 8.25 W maximum replaces the assumed SSD power, and the
    docs describe the RAID 0 boot layout and measured throughput.
    [01_atx_mobo_adapter_front.3mf, 02_atx_mobo_adapter_rail.3mf, 03_h12d_mobo_adapter_rail.3mf, 04_gpu_rest.3mf, 05_psu_brackets.3mf, 06_fan140_aio_frame.3mf, 07_fan140_aio_hose_brace.3mf, 08_fan120_aio_frame.3mf]
2026-11-11 Record H12D-8D SFF-8643 and SATA ports and user manual
    The product page and manual list three SFF-8643 ports, each PCIe 4.0 x4
    (U.2) or 4 x SATA, plus four SATA ports. With all four x16 slots holding
    V100s, an SFF-8643 port is the candidate host for a cabled riser and NIC.
    How a port is switched to PCIe mode, and whether two can be grouped as
    x8, is not documented and still needs checking in the BIOS.
2026-11-11 Add ConnectX-4 Lx link with SFF-8643 riser for Berserk
    Record the two owned ConnectX-4 Lx MCX4131A-GCAT 50GbE cards, one per
    system. Berserk's four x16 slots hold V100s, so its card goes on a
    Linkreal LRFC6911N riser fed by a 10Gtek 0.5 m SFF-8643 cable from an
    H12D-8D port in PCIe mode. Kenshin's card uses a chipset PCIEX4 slot,
    now listed in the X870E spec. Both links train at PCIe 3.0 x4.
    Riser and cable are selected for Newegg, not ordered, and not yet placed
    in the assembly. Open items: QSFP28 DAC cable, 300 LFM NIC airflow,
    Hercules SATA power lead count and Kenshin slot clearance under the
    RTX 5090.
    [parts.xlsx]
2026-11-13 Widen GPU base hexes to 6.0 mm and slice with OrcaSlicer 2.5
    Rear-rail hex openings for the SW5.5 Würth bases go from 5.8 to 6.0 mm
    across flats (0.25 mm clearance per face).
    The OrcaSlicer 2.5.0 Flatpak packs its system presets into .opc files the
    CLI cannot load. Vendor the Qidi base presets from the v2.5.0 tag in
    print/profiles/orca-2.5.0/ and have slice_jobs.py flatten each profile's
    inherits chain before slicing. 2.4.2 never applied the parent presets, so
    retraction, wipe, Z-hop and first-layer fan now follow the Qidi preset.
    An independent print audit found the 3 mm outer brim filled the full-length
    GPU-tab groove on both rails and the H12D hexes on layer 1. Plates 02 and 03
    now pri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
    [02_atx_mobo_adapter_rail.3mf, 03_h12d_mobo_adapter_rail.3mf, ac-power-cords.step, amd-epyc-7702p.step, atx_mobo_adapter_front.step, atx_mobo_adapter_rail.step, atx_mobo_adapter_rail.stl, corsair-h115i.step]
